TsBeNz/Narwhal-Robot-Embedded-Systems/README.md

# Module89-Frab5-G3
Electronics &amp; Embedded Systems
