TsBeNz/Narwhal-Robot-Embedded-Systems/Matlabscript_simscape/Simscape/NarwhaleCAD/GripperASM.STL

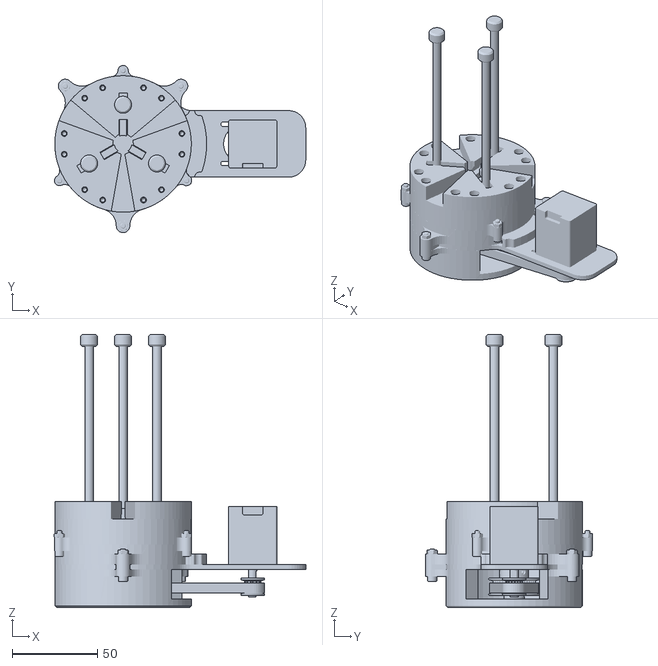
[picture p1: CAD file, 2022-02-24]
Matlabscript_simscape/Simscape/NarwhaleCAD/GripperASM.STL
147.4 x 98.0 x 160.0
