TsBeNz/Narwhal-Robot-Embedded-Systems/Matlabscript_simscape/Simscape/NarwhaleCAD/assJ5.SLDASM

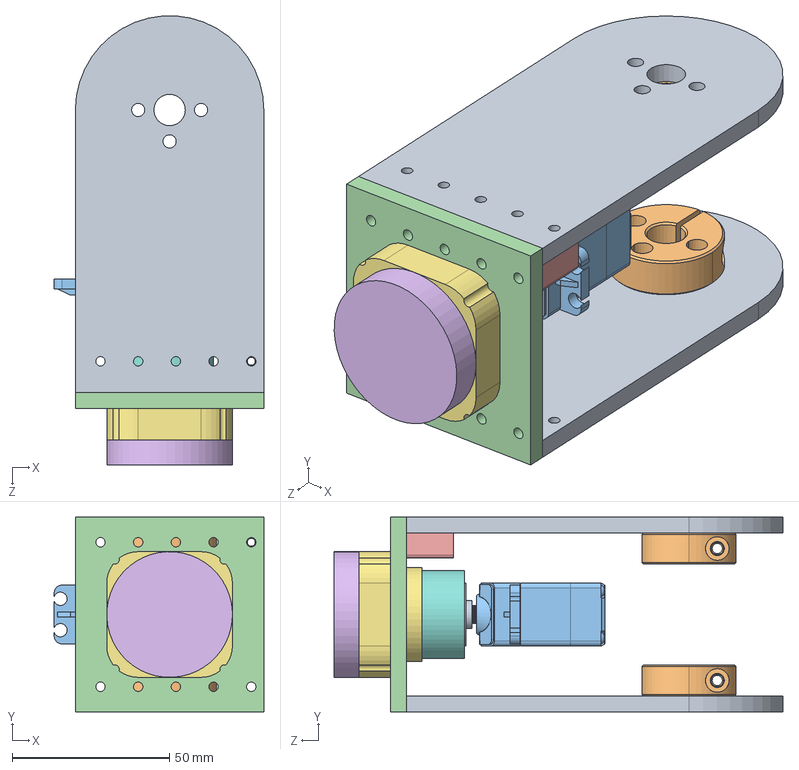
[picture p2: CAD file, 2022-01-18]
Matlabscript_simscape/Simscape/NarwhaleCAD/assJ5.SLDASM
66.8 x 62.0 x 142.9 mm
SP_J5 x 2
PSCST10_10_5 x 2
end-effector-servo
SP5
Lock
mount_gripper
mount_bearing
Servo_connect
servo-rotator-plate
SFLC608ZZ
