TsBeNz/Narwhal-Robot-Embedded-Systems/(list of files, cad)

Other CAD files:
Matlabscript_simscape/Simscape/NarwhaleCAD/J5.STEP
Matlabscript_simscape/Simscape/NarwhaleCAD/link4.STL
