TsBeNz/Narwhal-Robot-Embedded-Systems/Board/NarwhelMainV2/NarwhelMainV2.pdf

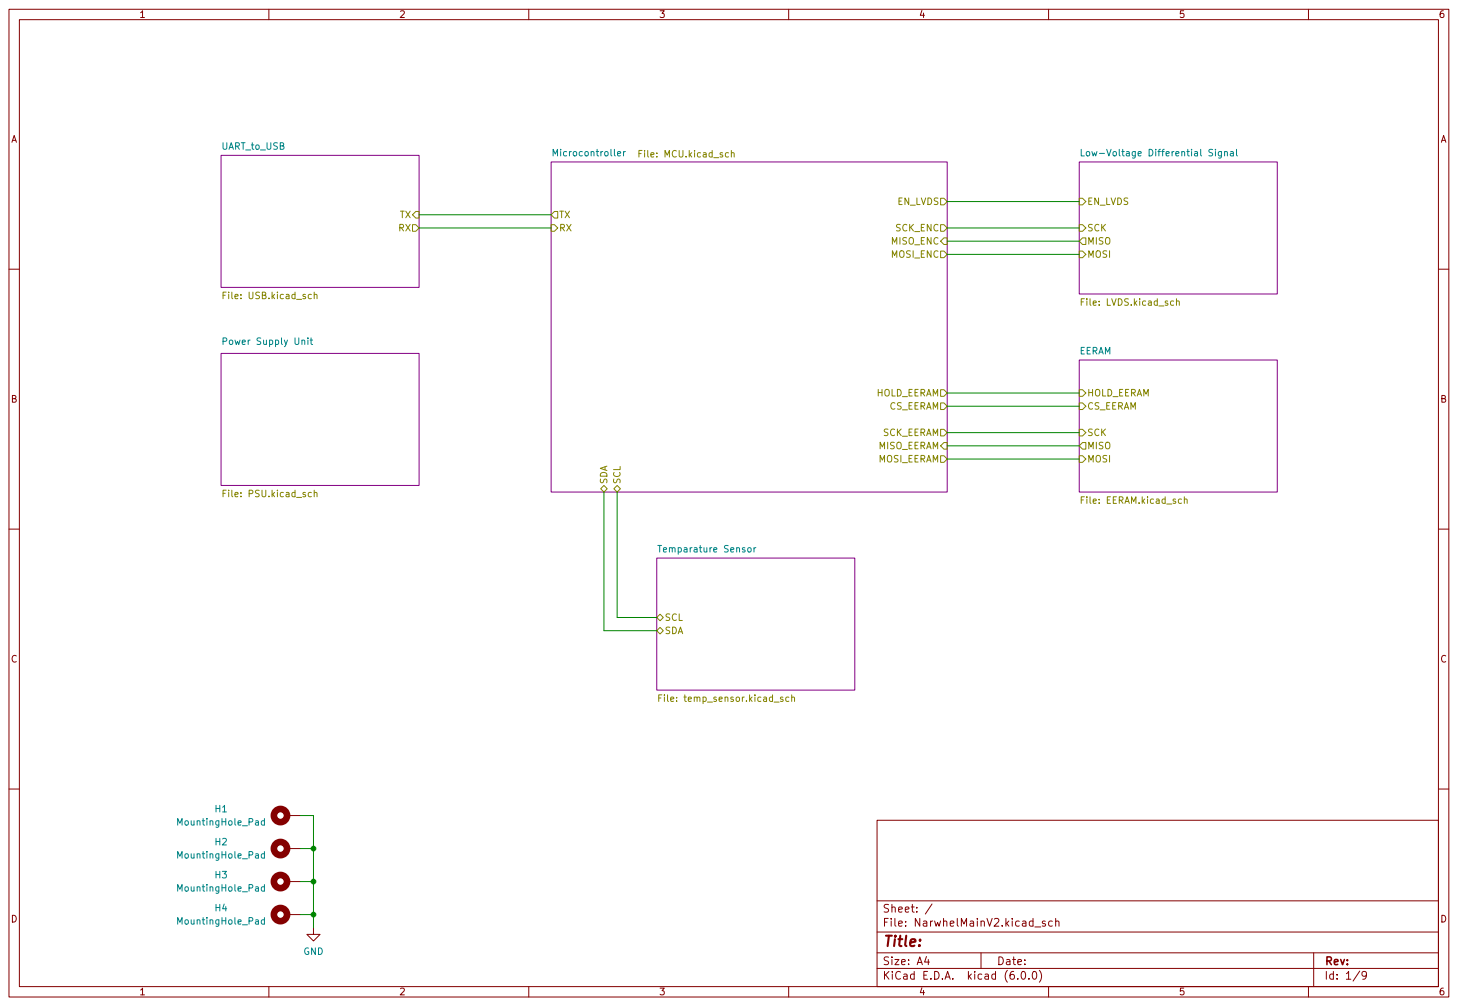
[picture p3: page 1]

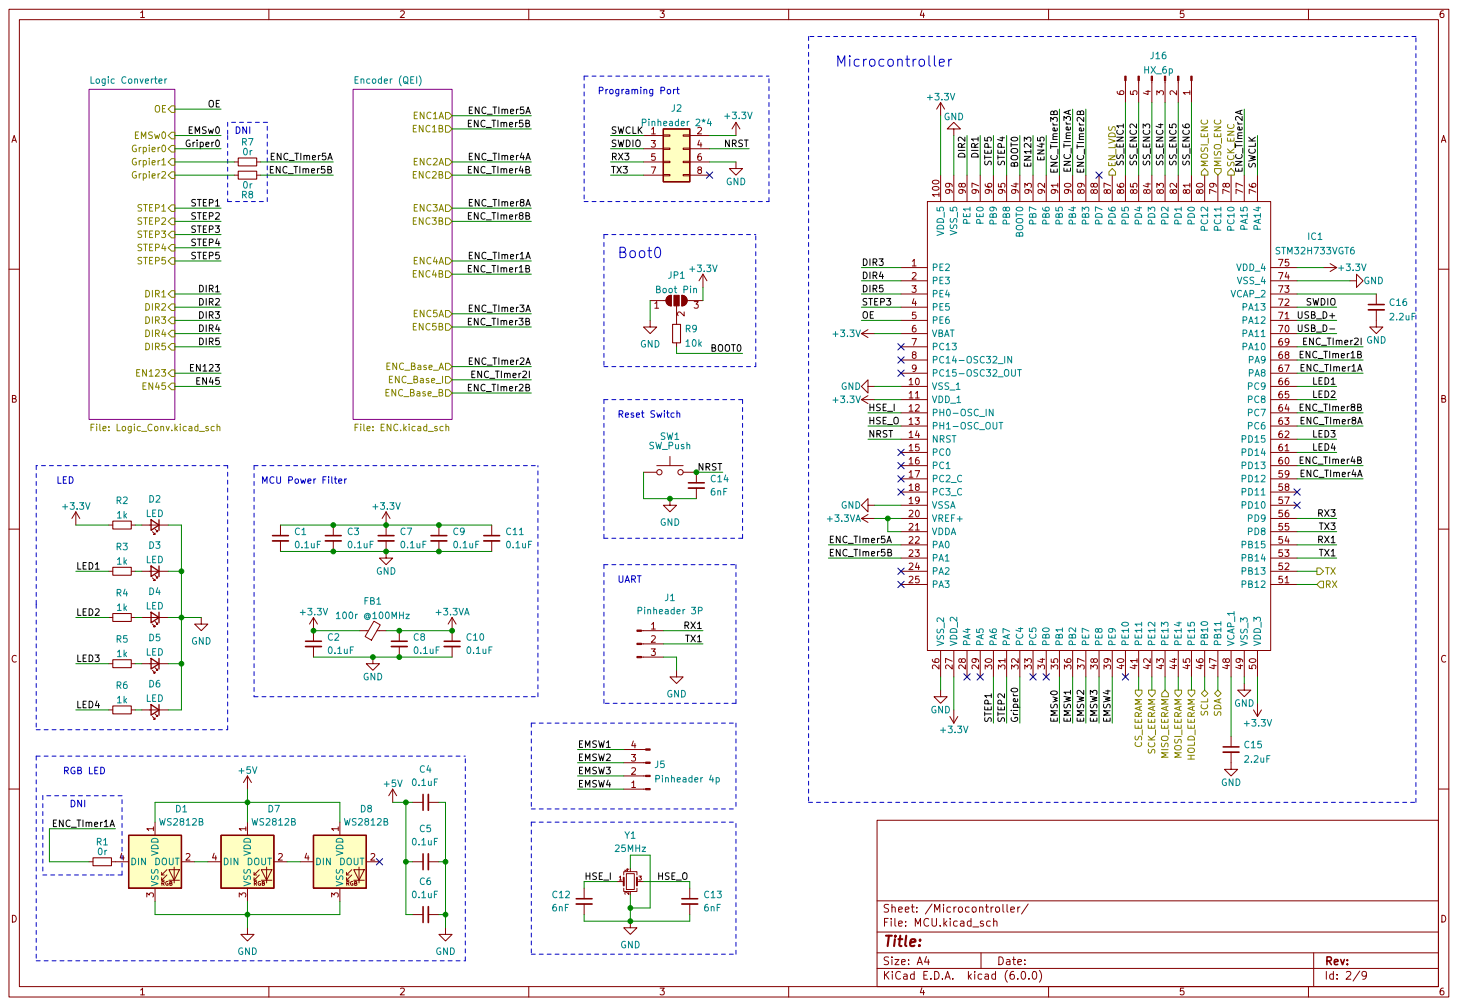
[picture p4: page 2]

File: MCU.kicad_sch Sheet: /Microcontroller/
Id: 2/9 Title:

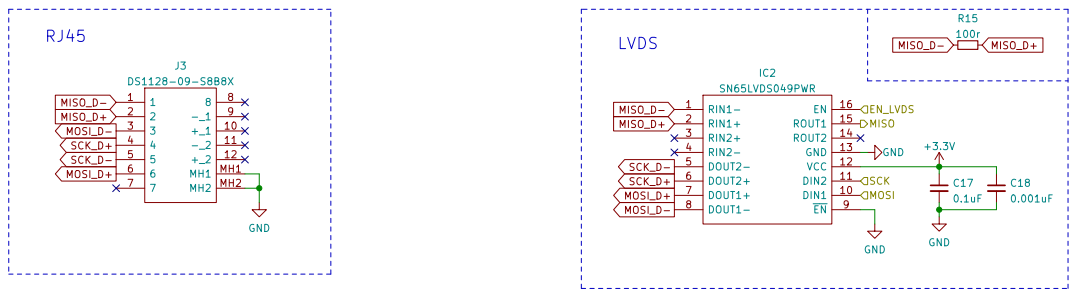
[picture p5: page 3]

Sheet: /Low-Voltage Differential Signal/ GND GND

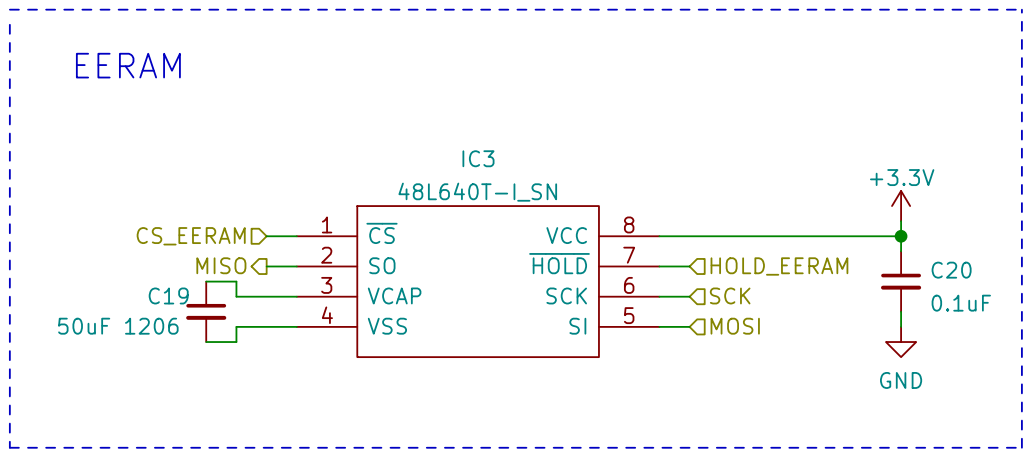
[picture p6: page 4]

File: EERAM.kicad_sch Sheet: /EERAM/ C19

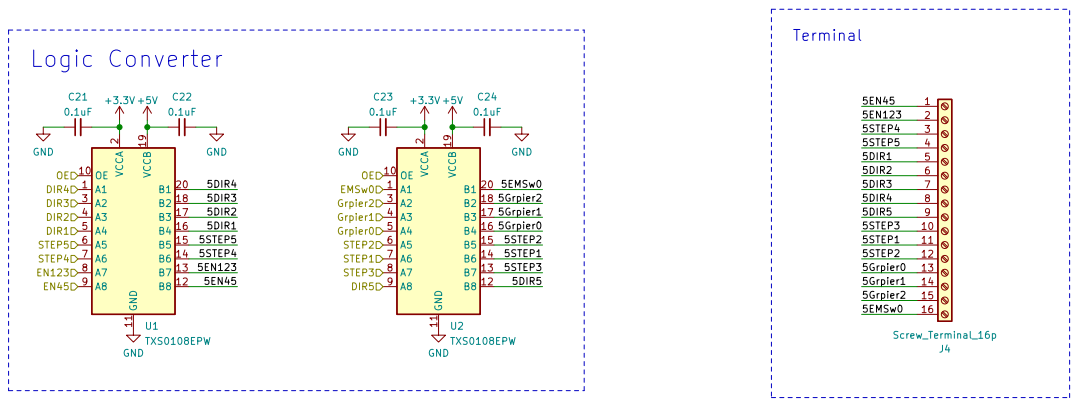
[picture p7: page 5]

Sheet: /Microcontroller/Logic Converter/
File: Logic_Conv.kicad_sch
Id: 5/9 Title:

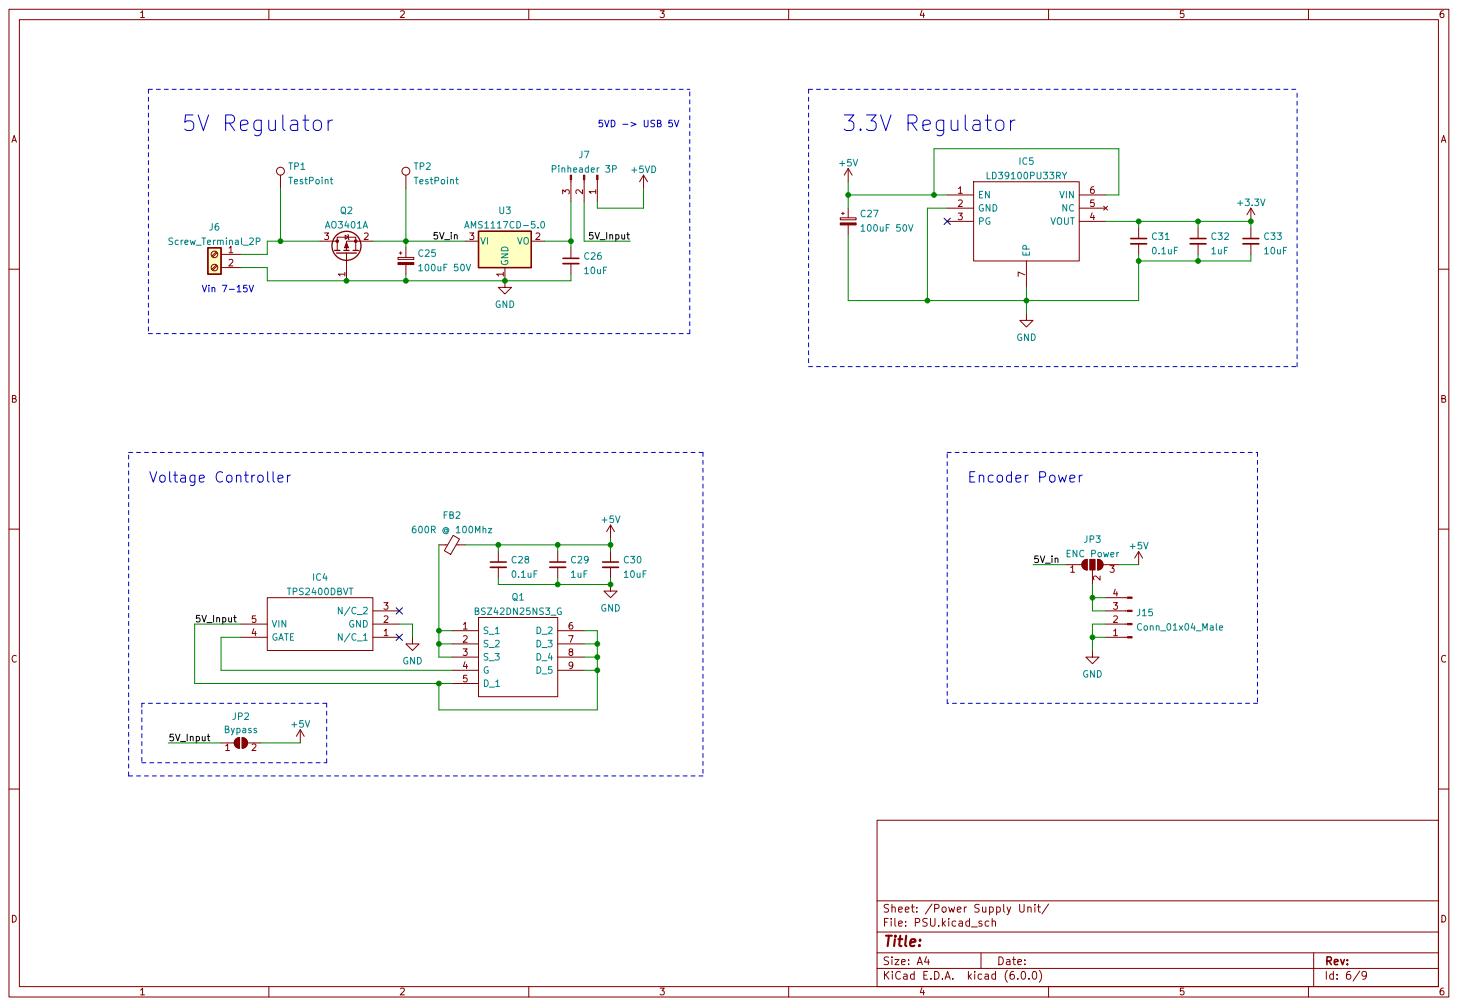
[picture p8: page 6]

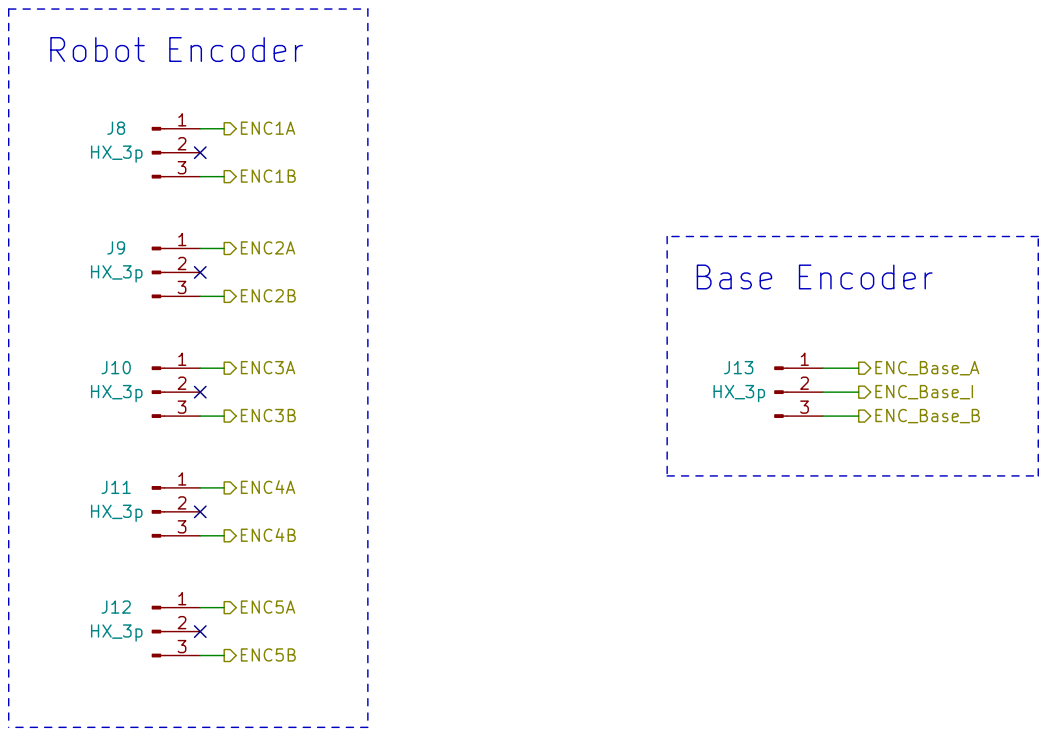
[picture p9: page 7]

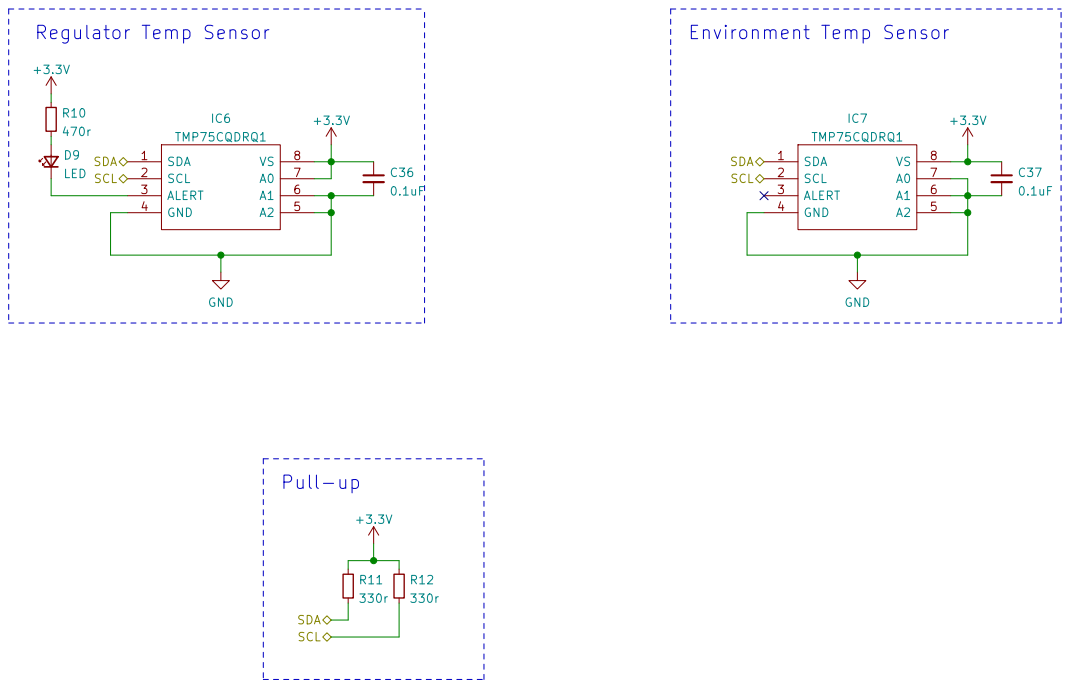
[picture p10: page 8]

Sheet: /Temparature Sensor/ GND

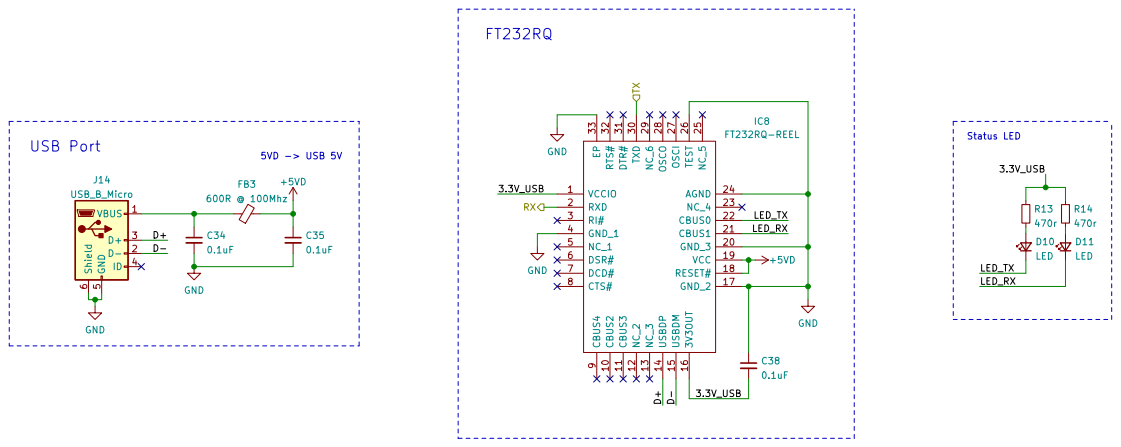
[picture p11: page 9]
