TsBeNz/Narwhal-Robot-Embedded-Systems/Board/NarWhelEncoderV2/NarWhelEncoderV2.kicad_pcb

## KiCad design Board/NarWhelEncoderV2/NarWhelEncoderV2.kicad_pcb (2022-01-24)

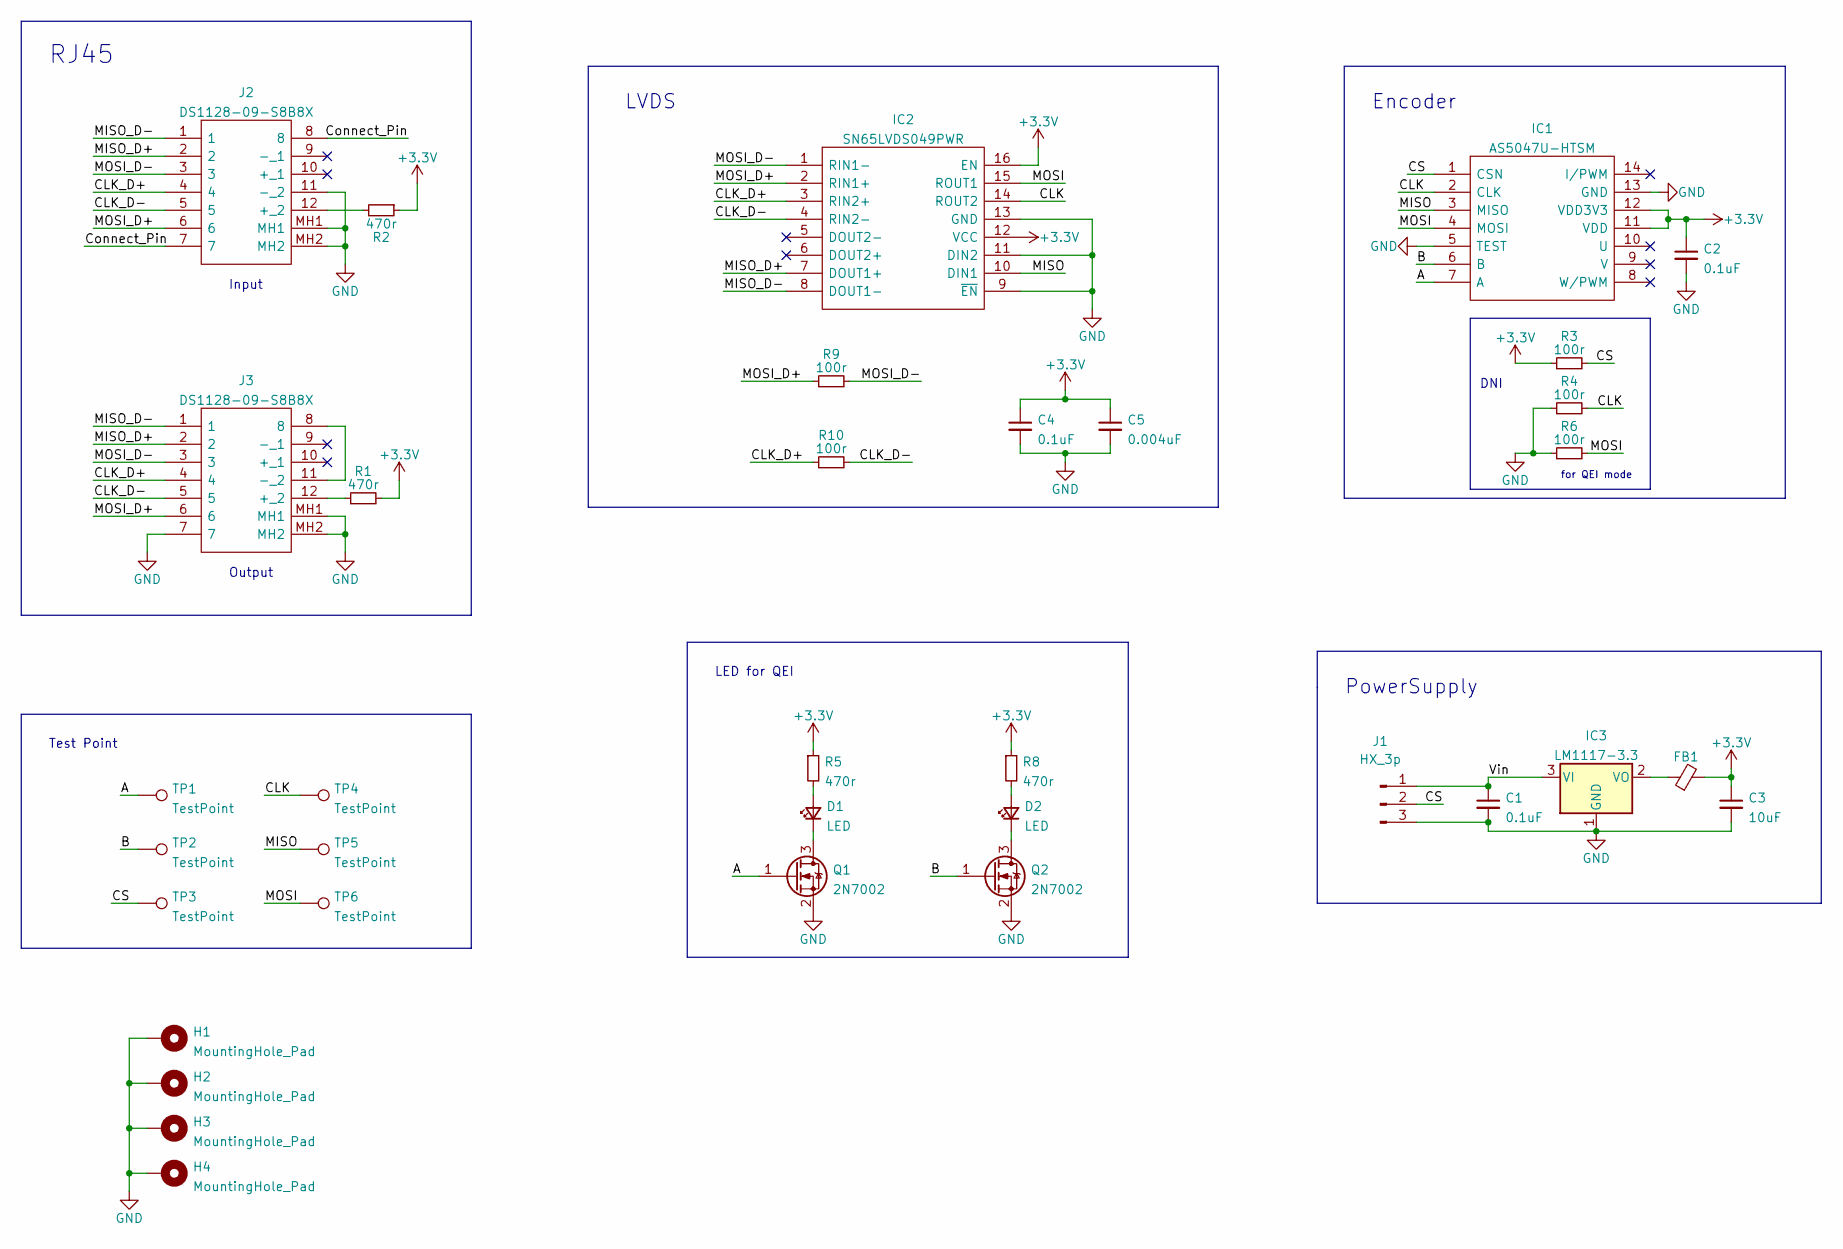
[picture p12: schematic NarWhelEncoderV2.kicad_sch]

Parts:
C1, C2, C4: 0.1uF; C_0603_1608Metric_Pad1.08x0.95mm_HandSolder
C3: 10uF; C_0603_1608Metric_Pad1.08x0.95mm_HandSolder
C5: 0.004uF; C_0603_1608Metric_Pad1.08x0.95mm_HandSolder
D1, D2: LED; LED_0603_1608Metric_Pad1.05x0.95mm_HandSolder
FB1: FerriteBead_Small; L_0603_1608Metric_Pad1.05x0.95mm_HandSolder
H1, H2, H3, H4: MountingHole_Pad; MountingHole_3.2mm_M3_Pad_Via
IC1: AS5047U-HTSM; SOP65P640X120-14N; Manufacturer_Part_Number AS5047U-HTSM; Mouser Part Number 985-AS5047U-HTSM
IC2: SN65LVDS049PWR; SOP65P640X120-16N; Manufacturer_Part_Number SN65LVDS049PWR; Mouser Part Number 595-SN65LVDS049PWR
IC3: LM1117-3.3; SOT-223-3_TabPin2
J1: HX_3p; JST_XH_B3B-XH-A_1x03_P2.50mm_Vertical
J2, J3: DS1128-09-S8B8X; DS112809S8B8X; Manufacturer_Part_Number DS1128-09-S8B8X
Q1, Q2: 2N7002; SOT-23_Handsoldering
R1, R2, R5, R8: 470r; R_0603_1608Metric_Pad0.98x0.95mm_HandSolder
R3, R4, R6, R9, R10: 100r; R_0603_1608Metric_Pad0.98x0.95mm_HandSolder
TP1, TP2, TP3, TP4, TP5, TP6: TestPoint; TestPoint_Pad_D1.5mm

Connections:
+3V3: C2.1, C3.1, C4.1, C5.1, FB1.2, IC1.11 (VDD), IC1.12 (VDD3V3), IC2.12 (VCC), IC2.16 (EN), R1.2, R2.1, R3.1, R5.1, R8.1
/A: IC1.7 (A), Q1.1 (G), TP1.1
/B: IC1.6 (B), Q2.1 (G), TP2.1
/CLK: IC1.2 (CLK), IC2.14 (ROUT2), R4.2, TP4.1
/CLK_D+: IC2.3 (RIN2+), J2.4, J3.4, R10.1
/CLK_D-: IC2.4 (RIN2-), J2.5, J3.5, R10.2
/CS: IC1.1 (CSN), J1.2, R3.2, TP3.1
/Connect_Pin: J2.7, J2.8
/MISO: IC1.3 (MISO), IC2.10 (DIN1), TP5.1
/MISO_D+: IC2.7 (DOUT1+), J2.2, J3.2
/MISO_D-: IC2.8 (DOUT1-), J2.1, J3.1
/MOSI: IC1.4 (MOSI), IC2.15 (ROUT1), R6.2, TP6.1
/MOSI_D+: IC2.2 (RIN1+), J2.6, J3.6, R9.1
/MOSI_D-: IC2.1 (RIN1-), J2.3, J3.3, R9.2
/Vin: C1.1, IC3.3 (VI), J1.1
GND: C1.2, C2.2, C3.2, C4.2, C5.2, H1.1, H2.1, H3.1, H4.1, IC1.5 (TEST), IC1.13 (GND), IC2.9 (~EN), IC2.11 (DIN2), IC2.13 (GND), IC3.1 (GND), J1.3, J2.11 (-_2), J2.MH1, J2.MH2, J3.7, J3.MH1, J3.MH2, Q1.2 (S), Q2.2 (S), R4.1, R6.1
unnamed: D1.1 (K), Q1.3 (D)
unnamed: D1.2 (A), R5.2
unnamed: D2.1 (K), Q2.3 (D)
unnamed: D2.2 (A), R8.2
unnamed: FB1.1, IC3.2 (VO)
unnamed: J2.12 (+_2), R2.2
unnamed: J3.8, J3.11 (-_2)
unnamed: J3.12 (+_2), R1.1

Notes on the sheet:
LED for QEI
Output
Test Point
Encoder
RJ45
Input
LVDS
PowerSupply
DNI
for QEI mode

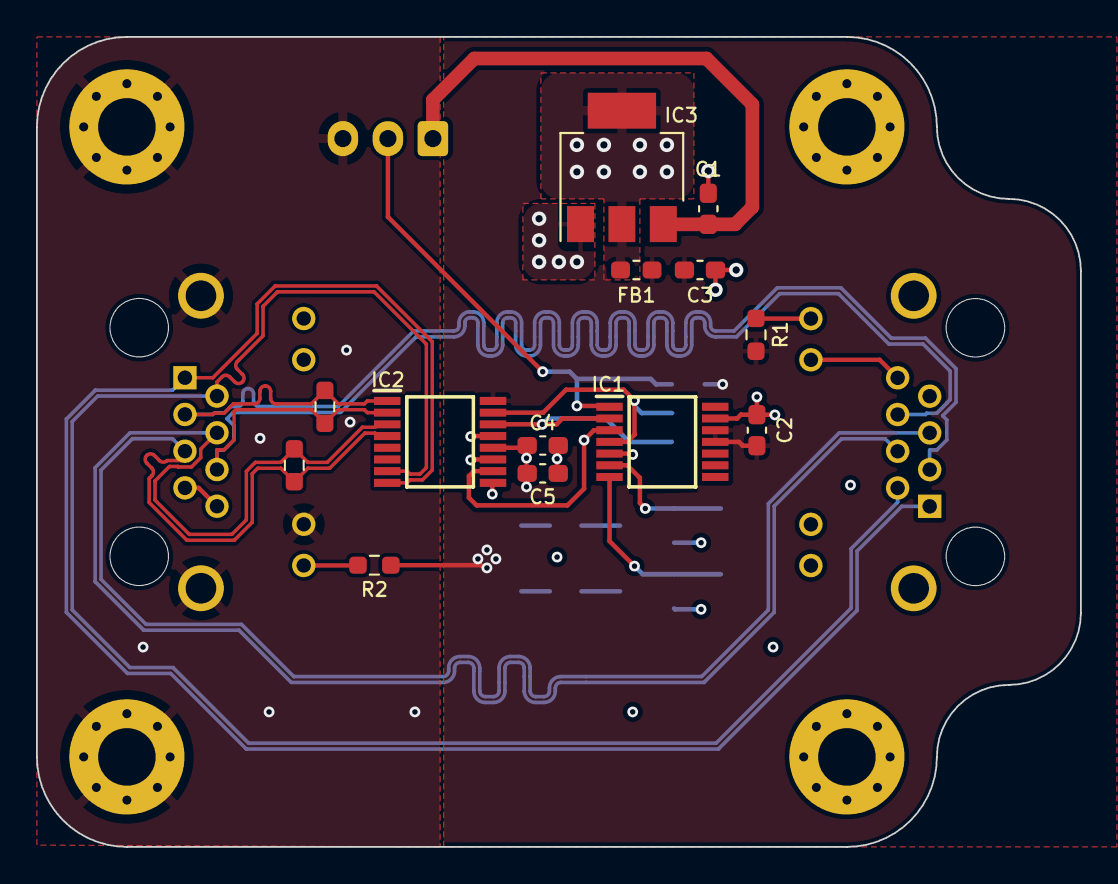
[picture p13: board NarWhelEncoderV2.kicad_pcb from above]

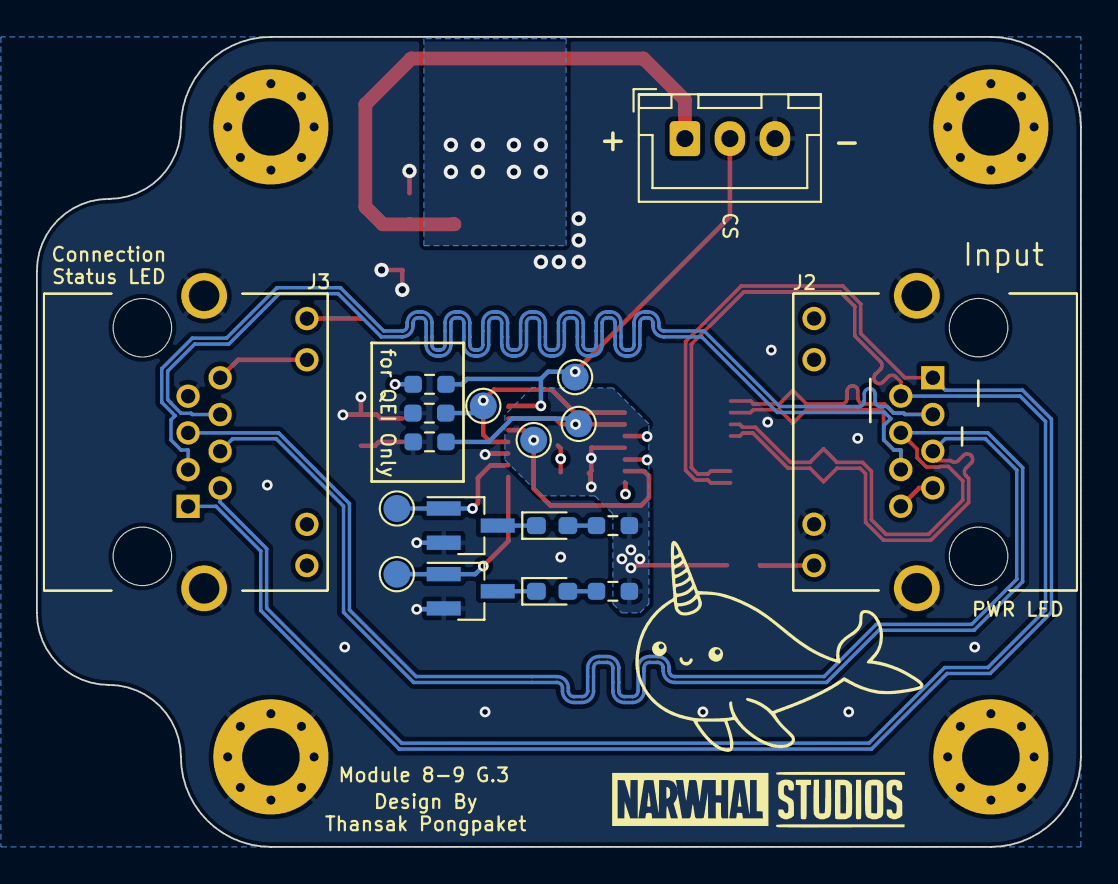
[picture p14: board NarWhelEncoderV2.kicad_pcb from below]

Board: 4 copper layers, 58.0 x 45.0 mm, 35 parts (18 on the bottom side), 24 nets.
