TsBeNz/Narwhal-Robot-Embedded-Systems/Board/NarwhelMainV2/NarwhelMainV2.kicad_pcb

## KiCad design Board/NarwhelMainV2/NarwhelMainV2.kicad_pcb (2022-01-24)

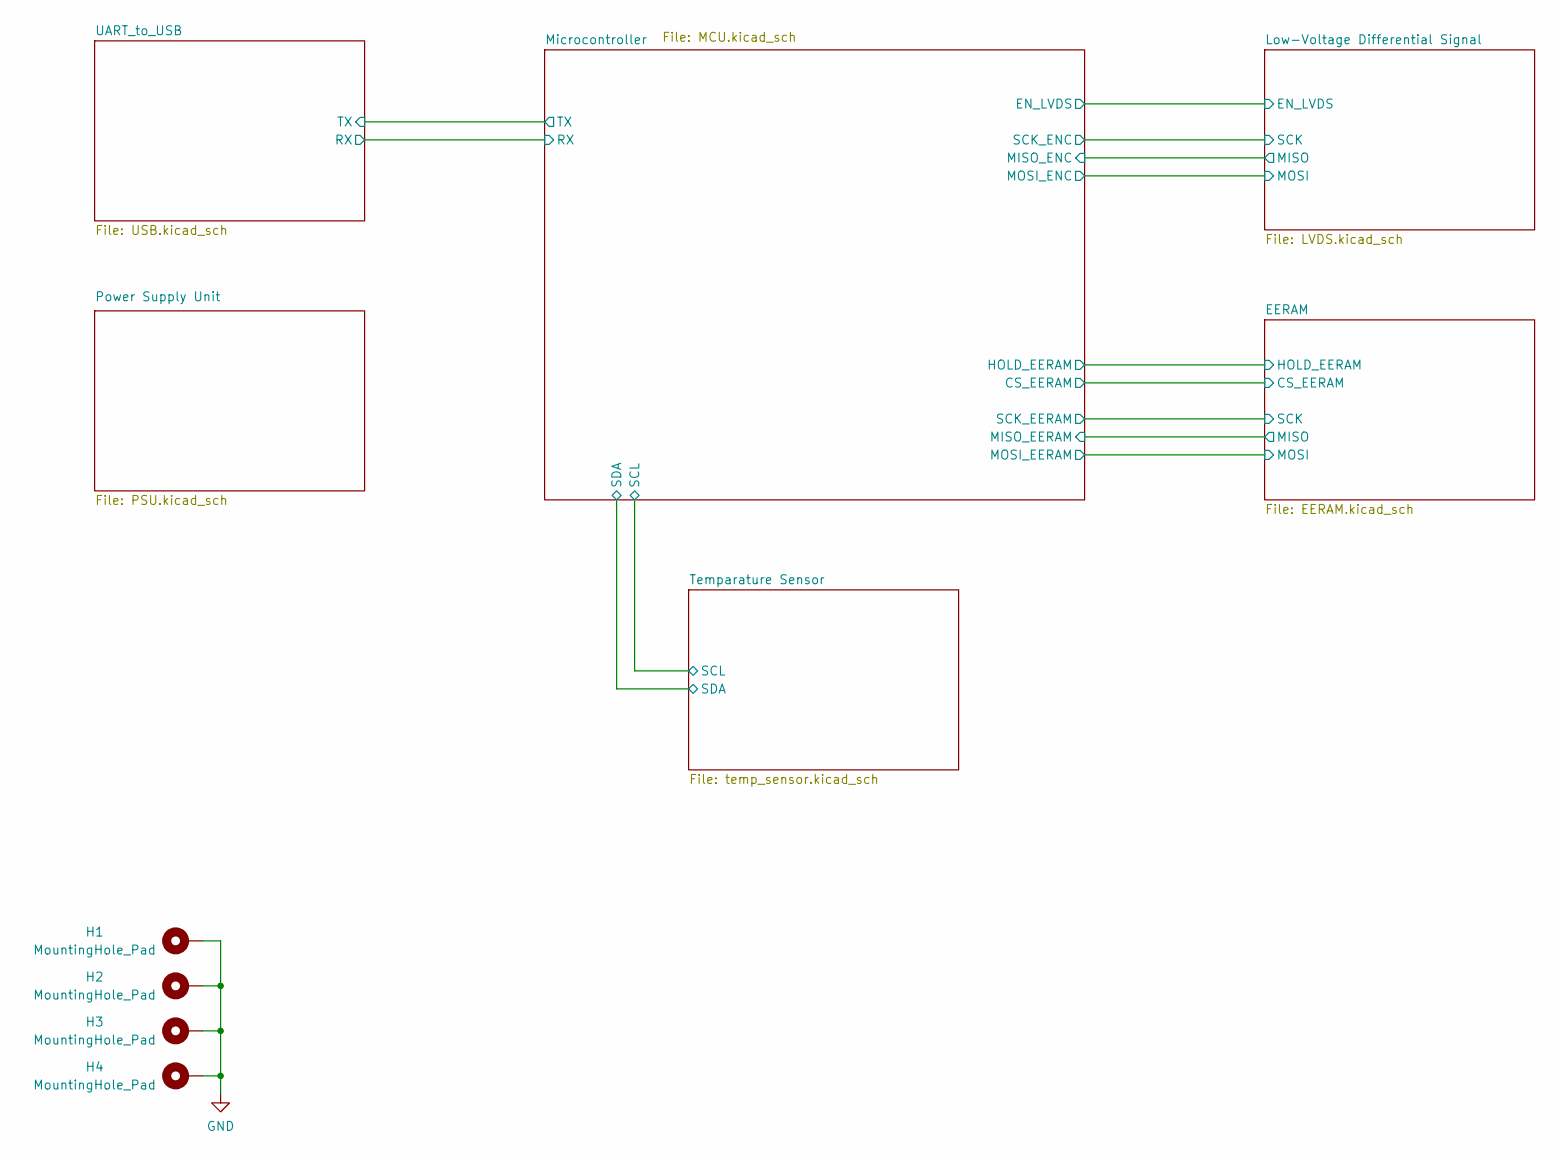
[picture p15: schematic NarwhelMainV2.kicad_sch]

Parts:
H1, H2, H3, H4: MountingHole_Pad; MountingHole_3.2mm_M3_Pad_Via

Connections:
GND: H1.1, H2.1, H3.1, H4.1; also elsewhere on the board

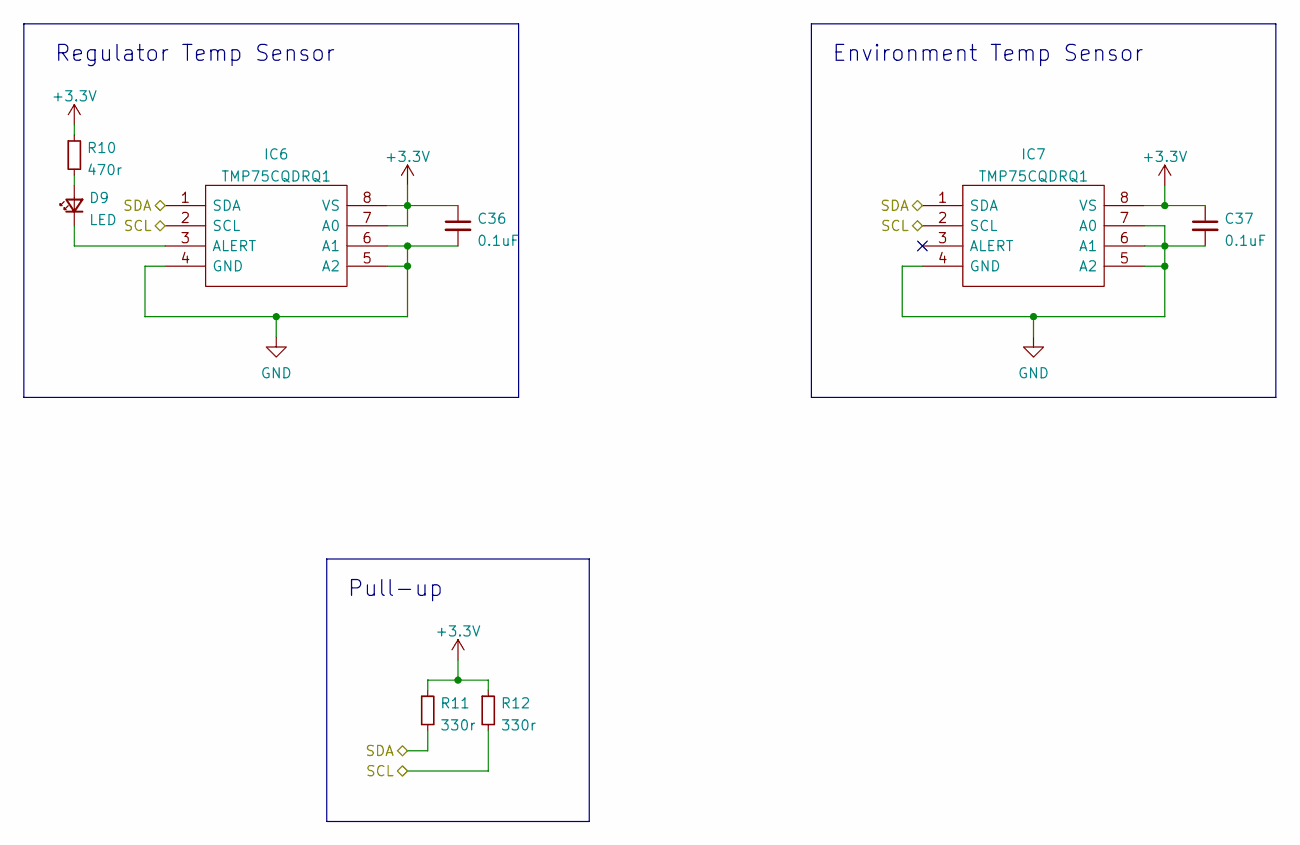
[picture p16: schematic temp_sensor.kicad_sch]

Parts:
C36, C37: 0.1uF; C_0603_1608Metric_Pad1.08x0.95mm_HandSolder
D9: LED; LED_0603_1608Metric_Pad1.05x0.95mm_HandSolder
IC6, IC7: TMP75CQDRQ1; SOIC127P600X175-8N; Manufacturer_Part_Number TMP75CQDRQ1; Mouser Part Number 595-TMP75CQDRQ1
R10: 470r; R_0603_1608Metric_Pad0.98x0.95mm_HandSolder
R11, R12: 330r; R_0603_1608Metric_Pad0.98x0.95mm_HandSolder

Connections:
+3V3: C36.1, C37.1, IC6.7 (A0), IC6.8 (VS), IC7.8 (VS), R10.1, R11.1, R12.1; also elsewhere on the board
/Microcontroller/SCL: IC6.2 (SCL), IC7.2 (SCL), R12.2; also elsewhere on the board
/Microcontroller/SDA: IC6.1 (SDA), IC7.1 (SDA), R11.2; also elsewhere on the board
GND: C36.2, C37.2, IC6.4 (GND), IC6.5 (A2), IC6.6 (A1), IC7.4 (GND), IC7.5 (A2), IC7.6 (A1), IC7.7 (A0); also elsewhere on the board
unnamed: D9.1 (K), IC6.3 (ALERT)
unnamed: D9.2 (A), R10.2

Notes on the sheet:
Regulator Temp Sensor
Environment Temp Sensor
Pull-up

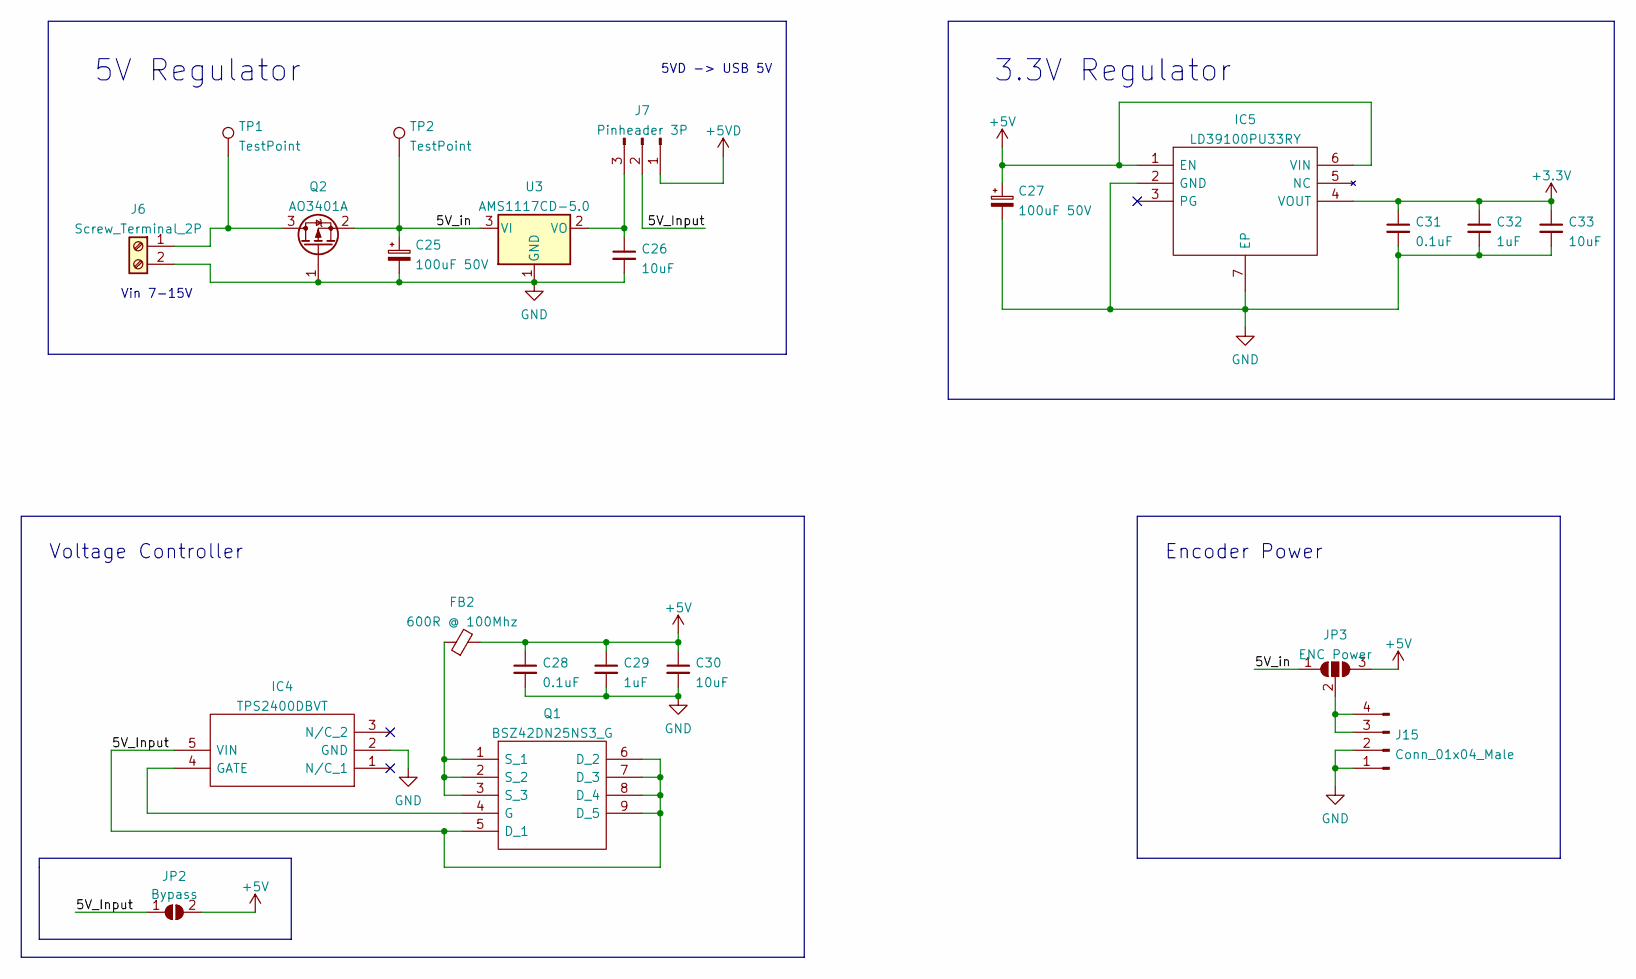
[picture p17: schematic PSU.kicad_sch]

Parts:
C25, C27: 100uF 50V; CP_Elec_6.3x5.4_Nichicon
C26, C30, C33: 10uF; C_0603_1608Metric_Pad1.08x0.95mm_HandSolder
C28, C31: 0.1uF; C_0603_1608Metric_Pad1.08x0.95mm_HandSolder
C29, C32: 1uF; C_0603_1608Metric_Pad1.08x0.95mm_HandSolder
FB2: 600R @ 100Mhz; L_0603_1608Metric_Pad1.05x0.95mm_HandSolder
IC4: TPS2400DBVT; SOT95P280X145-5N; Manufacturer_Part_Number TPS2400DBVT; Mouser Part Number 595-TPS2400DBVT
IC5: LD39100PU33RY; SON95P300X300X90-7N-D; Manufacturer_Part_Number LD39100PU33RY; Mouser Part Number 511-LD39100PU33RY
J6: Screw_Terminal_2P; TerminalBlock_Phoenix_MKDS-1,5-2_1x02_P5.00mm_Horizontal
J7: Pinheader 3P; PinHeader_1x03_P2.54mm_Vertical
J15: Conn_01x04_Male; JST_XH_B4B-XH-A_1x04_P2.50mm_Vertical
JP2: Bypass; SolderJumper-2_P1.3mm_Open_RoundedPad1.0x1.5mm
JP3: ENC Power; SolderJumper-3_P1.3mm_Open_RoundedPad1.0x1.5mm
Q1: BSZ42DN25NS3_G; BSZ42DN25NS3G; Manufacturer_Part_Number BSZ42DN25NS3 G; Mouser Part Number 726-BSZ42DN25NS3G
Q2: AO3401A; SOT-23
TP1, TP2: TestPoint; TestPoint_THTPad_D2.0mm_Drill1.0mm
U3: AMS1117CD-5.0; TO-252-3_TabPin2

Connections:
+3V3: C31.1, C32.1, C33.1, IC5.4 (VOUT); also elsewhere on the board
+5V: C27.1, C28.1, C29.1, C30.1, FB2.2, IC5.1 (EN), IC5.6 (VIN), JP2.2 (B), JP3.3 (B); also elsewhere on the board
+5VD: J7.1; also elsewhere on the board
/Power Supply Unit/5V_Input: IC4.5 (VIN), J7.2, JP2.1 (A), Q1.5 (D_1), Q1.6 (D_2), Q1.7 (D_3), Q1.8 (D_4), Q1.9 (D_5)
/Power Supply Unit/5V_in: C25.1, JP3.1 (A), Q2.2 (S), TP2.1, U3.3 (VI)
GND: C25.2, C26.2, C27.2, C28.2, C29.2, C30.2, C31.2, C32.2, C33.2, IC4.2 (GND), IC5.2 (GND), IC5.7 (EP), J6.2, J15.1, J15.2, Q2.1 (G), U3.1 (GND); also elsewhere on the board
unnamed: C26.1, J7.3, U3.2 (VO)
unnamed: FB2.1, Q1.1 (S_1), Q1.2 (S_2), Q1.3 (S_3)
unnamed: IC4.4 (GATE), Q1.4 (G)
unnamed: J6.1, Q2.3 (D), TP1.1
unnamed: J15.3, J15.4, JP3.2 (C)

Notes on the sheet:
5V Regulator
5VD -> USB 5V
Encoder Power
Voltage Controller
3.3V Regulator
Vin 7-15V

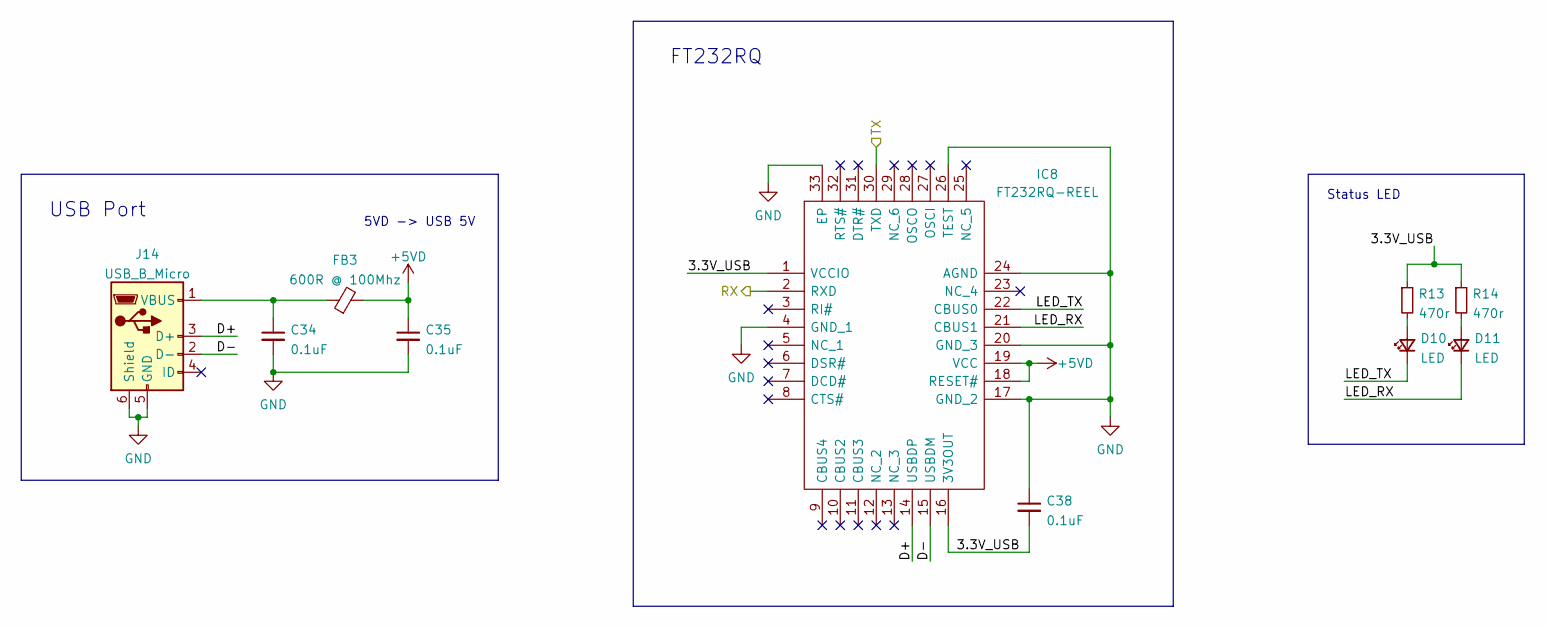
[picture p18: schematic USB.kicad_sch]

Parts:
C34, C35, C38: 0.1uF; C_0603_1608Metric_Pad1.08x0.95mm_HandSolder
D10, D11: LED; LED_0603_1608Metric_Pad1.05x0.95mm_HandSolder
FB3: 600R @ 100Mhz; L_0603_1608Metric_Pad1.05x0.95mm_HandSolder
IC8: FT232RQ-REEL; QFN50P500X500X90-33N-D; Manufacturer_Part_Number FT232RQ-REEL; Mouser Part Number 895-FT232RQ
J14: USB_B_Micro; USB_Micro-B_Molex_47346-0001
R13, R14: 470r; R_0603_1608Metric_Pad0.98x0.95mm_HandSolder

Connections:
+5VD: C35.1, FB3.2, IC8.18 (RESET#), IC8.19 (VCC); also elsewhere on the board
/Microcontroller/RX: IC8.2 (RXD); also elsewhere on the board
/Microcontroller/TX: IC8.30 (TXD); also elsewhere on the board
/UART_to_USB/3.3V_USB: C38.2, IC8.1 (VCCIO), IC8.16 (3V3OUT), R13.1, R14.1
/UART_to_USB/D+: IC8.14 (USBDP), J14.3 (D+)
/UART_to_USB/D-: IC8.15 (USBDM), J14.2 (D-)
/UART_to_USB/LED_RX: D11.1 (K), IC8.21 (CBUS1)
/UART_to_USB/LED_TX: D10.1 (K), IC8.22 (CBUS0)
GND: C34.2, C35.2, C38.1, IC8.4 (GND_1), IC8.17 (GND_2), IC8.20 (GND_3), IC8.24 (AGND), IC8.26 (TEST), IC8.33 (EP), J14.5 (GND), J14.6 (Shield); also elsewhere on the board
unnamed: C34.1, FB3.1, J14.1 (VBUS)
unnamed: D10.2 (A), R13.2
unnamed: D11.2 (A), R14.2

Notes on the sheet:
FT232RQ
5VD -> USB 5V
Status LED
USB Port

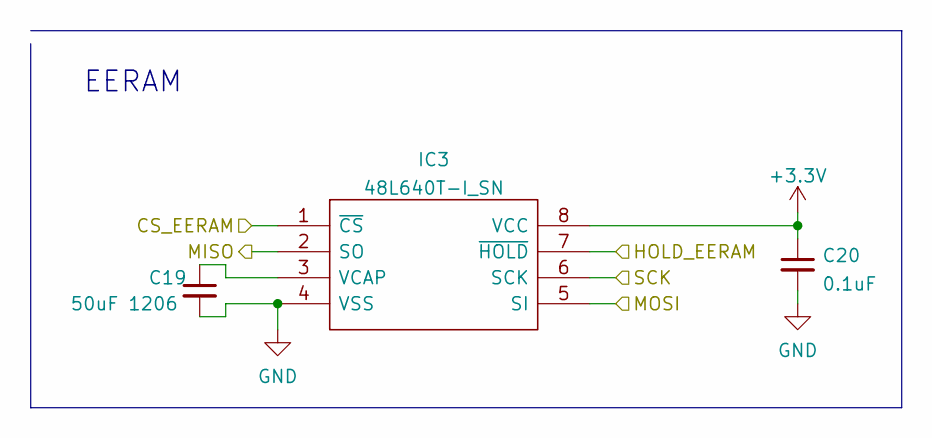
[picture p19: schematic EERAM.kicad_sch]

Parts:
C19: 50uF 1206; C_1206_3216Metric_Pad1.33x1.80mm_HandSolder
C20: 0.1uF; C_0603_1608Metric_Pad1.08x0.95mm_HandSolder
IC3: 48L640T-I_SN; SOIC127P600X175-8N; Manufacturer_Part_Number 48L640T-I/SN; Mouser Part Number 579-48L640T-I/SN

Connections:
+3V3: C20.1, IC3.8 (VCC); also elsewhere on the board
/EERAM/CS_EERAM: IC3.1 (~CS); also elsewhere on the board
/EERAM/HOLD_EERAM: IC3.7 (~HOLD); also elsewhere on the board
/EERAM/MISO: IC3.2 (SO); also elsewhere on the board
/EERAM/MOSI: IC3.5 (SI); also elsewhere on the board
/EERAM/SCK: IC3.6 (SCK); also elsewhere on the board
GND: C19.2, C20.2, IC3.4 (VSS); also elsewhere on the board
unnamed: C19.1, IC3.3 (VCAP)

Notes on the sheet:
EERAM

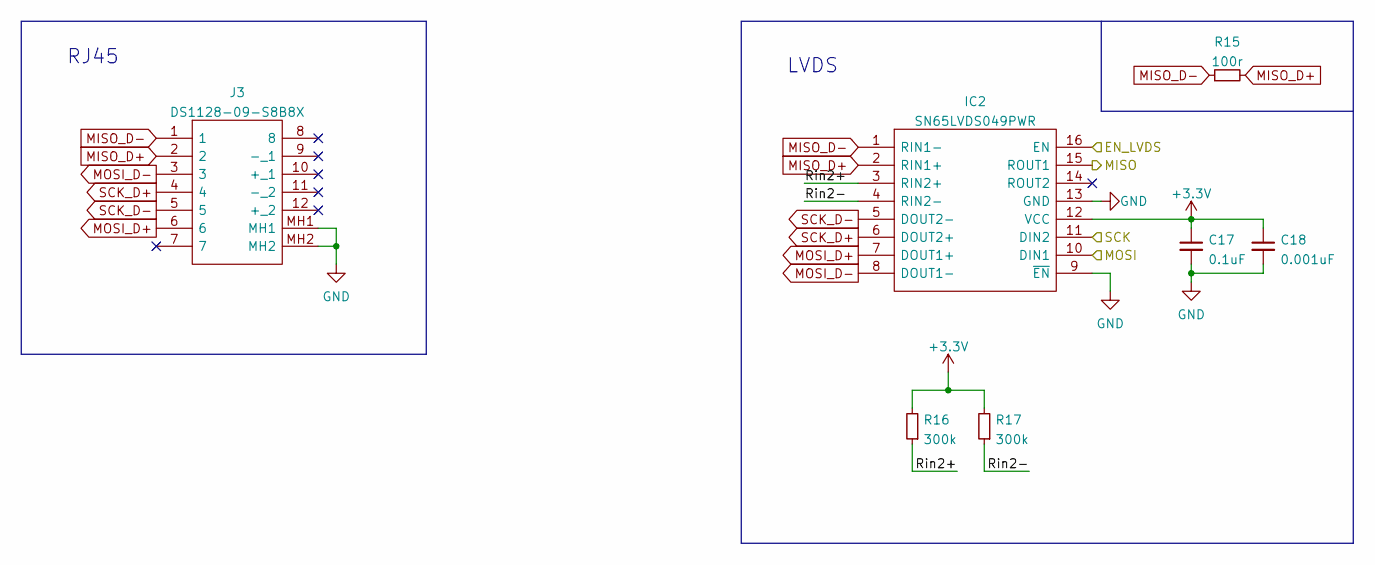
[picture p20: schematic LVDS.kicad_sch]

Parts:
C17: 0.1uF; C_0603_1608Metric_Pad1.08x0.95mm_HandSolder
C18: 0.001uF; C_0603_1608Metric_Pad1.08x0.95mm_HandSolder
IC2: SN65LVDS049PWR; SOP65P640X120-16N; Manufacturer_Part_Number SN65LVDS049PWR; Mouser Part Number 595-SN65LVDS049PWR
J3: DS1128-09-S8B8X; DS112809S8B8X; Manufacturer_Part_Number DS1128-09-S8B8X
R15: 100r; R_0603_1608Metric_Pad0.98x0.95mm_HandSolder
R16, R17: 300k; R_0402_1005Metric_Pad0.72x0.64mm_HandSolder

Connections:
+3V3: C17.1, C18.1, IC2.12 (VCC), R16.2, R17.2; also elsewhere on the board
/Low-Voltage Differential Signal/EN_LVDS: IC2.16 (EN); also elsewhere on the board
/Low-Voltage Differential Signal/MISO: IC2.15 (ROUT1); also elsewhere on the board
/Low-Voltage Differential Signal/MOSI: IC2.10 (DIN1); also elsewhere on the board
/Low-Voltage Differential Signal/Rin2+: IC2.3 (RIN2+), R16.1
/Low-Voltage Differential Signal/Rin2-: IC2.4 (RIN2-), R17.1
/Low-Voltage Differential Signal/SCK: IC2.11 (DIN2); also elsewhere on the board
GND: C17.2, C18.2, IC2.9 (~EN), IC2.13 (GND), J3.MH1, J3.MH2; also elsewhere on the board
MISO_D+: IC2.2 (RIN1+), J3.2, R15.2
MISO_D-: IC2.1 (RIN1-), J3.1, R15.1
MOSI_D+: IC2.7 (DOUT1+), J3.6
MOSI_D-: IC2.8 (DOUT1-), J3.3
SCK_D+: IC2.6 (DOUT2+), J3.4
SCK_D-: IC2.5 (DOUT2-), J3.5

Notes on the sheet:
RJ45
LVDS

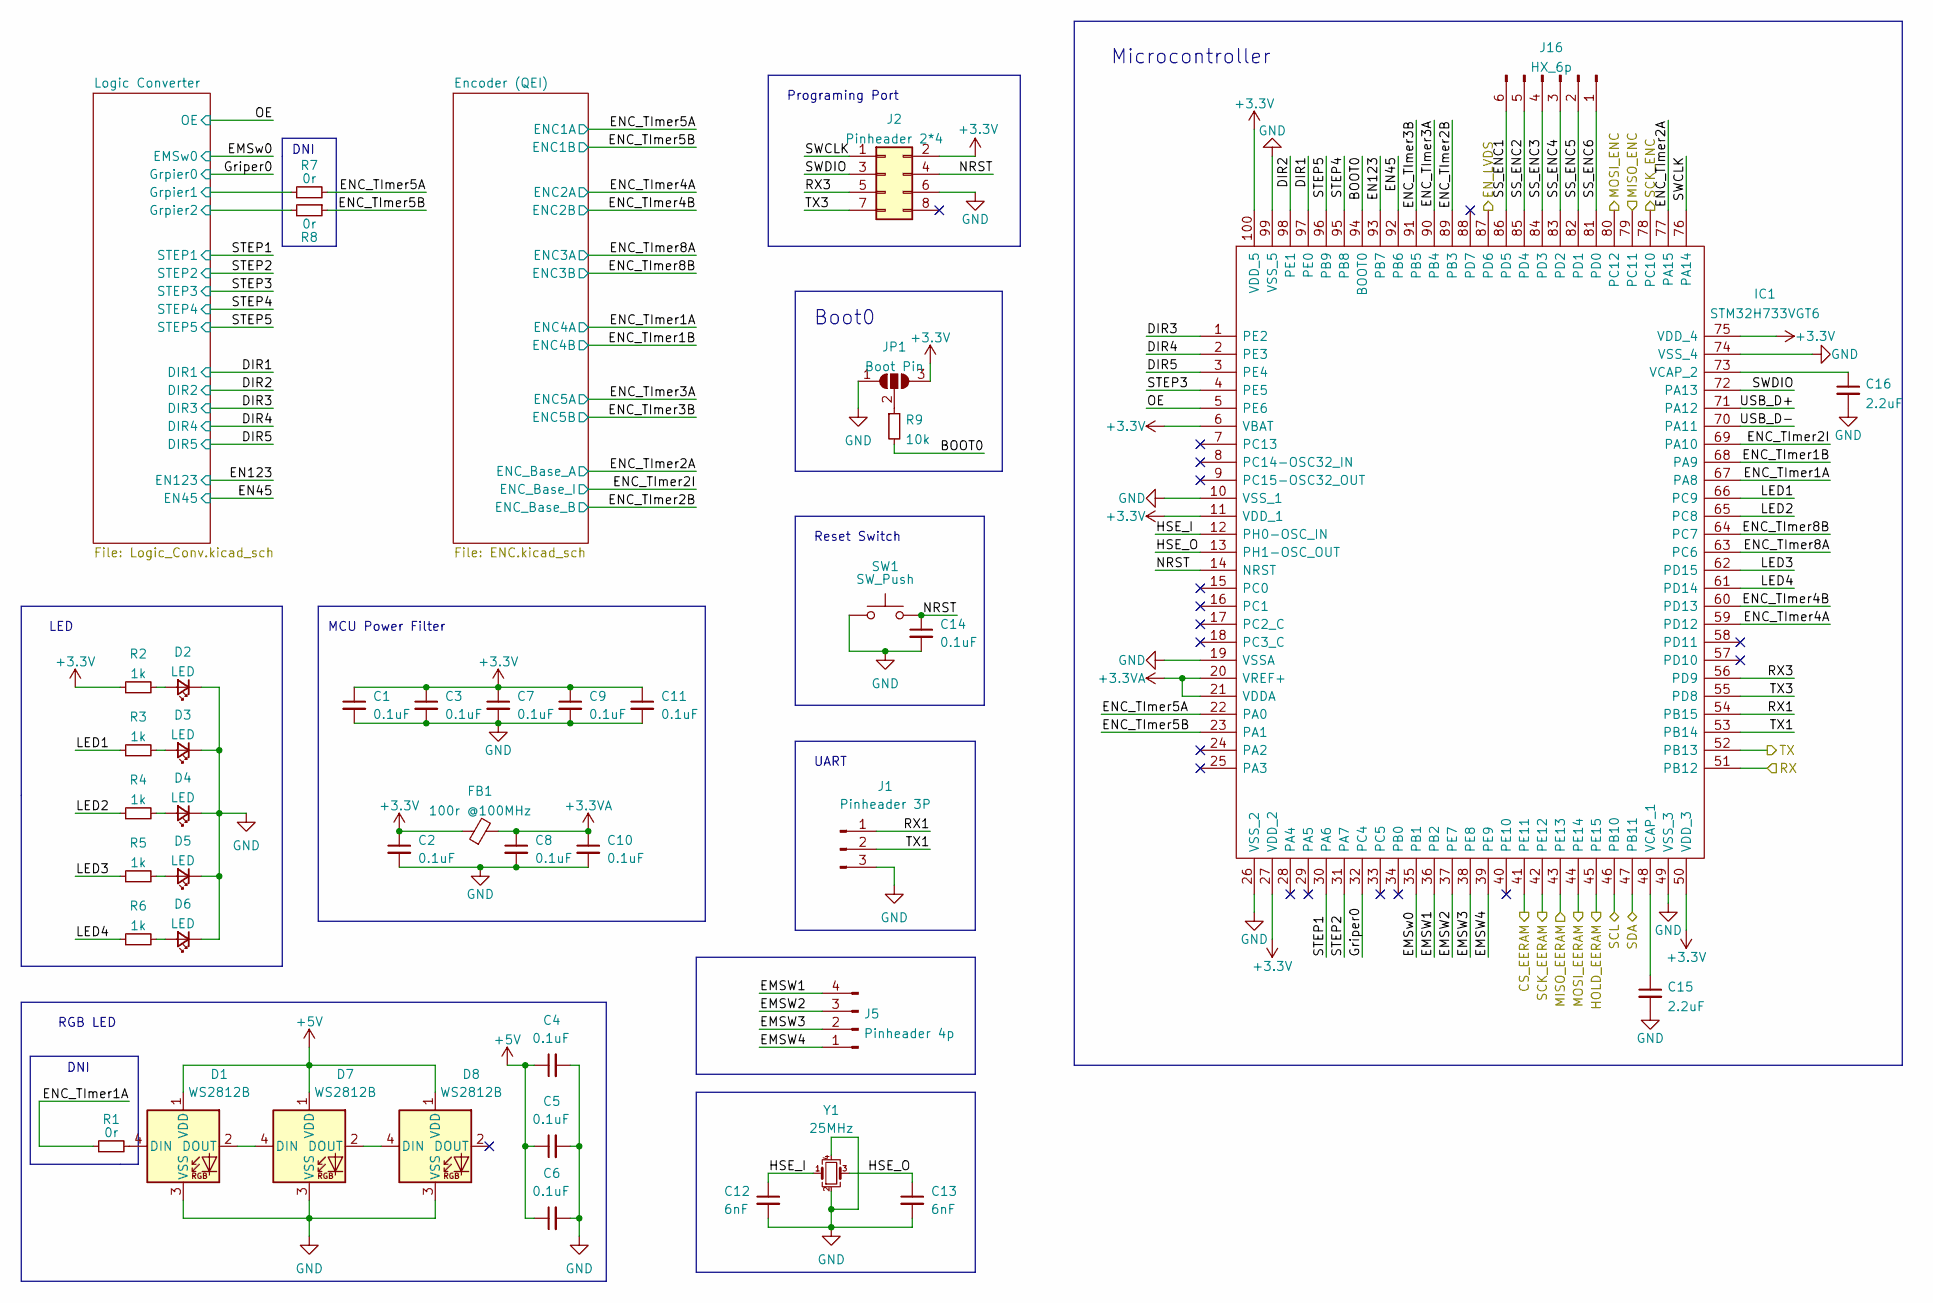
[picture p21: schematic MCU.kicad_sch]

Parts:
C1, C2, C3, C4, C5, C6, C7, C8, C9, C10, C11, C14: 0.1uF; C_0603_1608Metric_Pad1.08x0.95mm_HandSolder
C12, C13: 6nF; C_0603_1608Metric_Pad1.08x0.95mm_HandSolder
C15, C16: 2.2uF; C_0603_1608Metric_Pad1.08x0.95mm_HandSolder
D1, D7, D8: WS2812B; LED_WS2812B_PLCC4_5.0x5.0mm_P3.2mm
D2, D3, D4, D5, D6: LED; LED_0603_1608Metric_Pad1.05x0.95mm_HandSolder
FB1: 100r @100MHz; L_0603_1608Metric_Pad1.05x0.95mm_HandSolder
IC1: STM32H733VGT6; QFP50P1600X1600X160-100N; Manufacturer_Part_Number STM32H733VGT6; Mouser Part Number 511-STM32H733VGT6
J1: Pinheader 3P; PinHeader_1x03_P2.54mm_Vertical
J2: Pinheader 2*4; PinHeader_2x04_P2.54mm_Vertical
J5: Pinheader 4p; PinHeader_1x04_P2.54mm_Vertical
J16: HX_6p; JST_XH_B6B-XH-A_1x06_P2.50mm_Vertical
JP1: Boot Pin; SolderJumper-3_P2.0mm_Open_TrianglePad1.0x1.5mm
R1, R7, R8: 0r; R_0603_1608Metric_Pad0.98x0.95mm_HandSolder
R2, R3, R4, R5, R6: 1k; R_0603_1608Metric_Pad0.98x0.95mm_HandSolder
R9: 10k; R_0603_1608Metric_Pad0.98x0.95mm_HandSolder
SW1: SW_Push; SW_SPST_CK_RS282G05A3
Y1: 25MHz; Crystal_SMD_SeikoEpson_FA238-4Pin_3.2x2.5mm

Connections:
+3.3VA: C8.1, C10.1, FB1.2, IC1.20 (VREF+), IC1.21 (VDDA)
+3V3: C1.1, C2.1, C3.1, C7.1, C9.1, C11.1, FB1.1, IC1.6 (VBAT), IC1.11 (VDD_1), IC1.27 (VDD_2), IC1.50 (VDD_3), IC1.75 (VDD_4), IC1.100 (VDD_5), J2.2, JP1.3 (B), R2.1; also elsewhere on the board
+5V: C4.1, C5.1, C6.1, D1.1 (VDD), D7.1 (VDD), D8.1 (VDD); also elsewhere on the board
/EERAM/CS_EERAM: IC1.41 (PE11); also elsewhere on the board
/EERAM/HOLD_EERAM: IC1.45 (PE15); also elsewhere on the board
/EERAM/MISO: IC1.43 (PE13); also elsewhere on the board
/EERAM/MOSI: IC1.44 (PE14); also elsewhere on the board
/EERAM/SCK: IC1.42 (PE12); also elsewhere on the board
/Low-Voltage Differential Signal/EN_LVDS: IC1.87 (PD6); also elsewhere on the board
/Low-Voltage Differential Signal/MISO: IC1.79 (PC11); also elsewhere on the board
/Low-Voltage Differential Signal/MOSI: IC1.80 (PC12); also elsewhere on the board
/Low-Voltage Differential Signal/SCK: IC1.78 (PC10); also elsewhere on the board
/Microcontroller/BOOT0: IC1.94 (BOOT0), R9.2
/Microcontroller/DIR1: IC1.97 (PE0); also elsewhere on the board
/Microcontroller/DIR2: IC1.98 (PE1); also elsewhere on the board
/Microcontroller/DIR3: IC1.1 (PE2); also elsewhere on the board
/Microcontroller/DIR4: IC1.2 (PE3); also elsewhere on the board
/Microcontroller/DIR5: IC1.3 (PE4); also elsewhere on the board
/Microcontroller/EMSW1: IC1.36 (PB2), J5.4
/Microcontroller/EMSW2: IC1.37 (PE7), J5.3
/Microcontroller/EMSW3: IC1.38 (PE8), J5.2
/Microcontroller/EMSW4: IC1.39 (PE9), J5.1
/Microcontroller/EMSw0: IC1.35 (PB1); also elsewhere on the board
/Microcontroller/EN45: IC1.92 (PB6); also elsewhere on the board
/Microcontroller/EN123: IC1.93 (PB7); also elsewhere on the board
/Microcontroller/ENC_TImer1A: IC1.67 (PA8), R1.1; also elsewhere on the board
/Microcontroller/ENC_TImer1B: IC1.68 (PA9); also elsewhere on the board
/Microcontroller/ENC_TImer2A: IC1.77 (PA15); also elsewhere on the board
/Microcontroller/ENC_TImer2B: IC1.89 (PB3); also elsewhere on the board
/Microcontroller/ENC_TImer2I: IC1.69 (PA10); also elsewhere on the board
/Microcontroller/ENC_TImer3A: IC1.90 (PB4); also elsewhere on the board
/Microcontroller/ENC_TImer3B: IC1.91 (PB5); also elsewhere on the board
/Microcontroller/ENC_TImer4A: IC1.59 (PD12); also elsewhere on the board
/Microcontroller/ENC_TImer4B: IC1.60 (PD13); also elsewhere on the board
/Microcontroller/ENC_TImer5A: IC1.22 (PA0), R7.2; also elsewhere on the board
/Microcontroller/ENC_TImer5B: IC1.23 (PA1), R8.1; also elsewhere on the board
/Microcontroller/ENC_TImer8A: IC1.63 (PC6); also elsewhere on the board
/Microcontroller/ENC_TImer8B: IC1.64 (PC7); also elsewhere on the board
/Microcontroller/Griper0: IC1.32 (PC4); also elsewhere on the board
/Microcontroller/HSE_I: C12.1, IC1.12 (PH0-OSC_IN), Y1.1
/Microcontroller/HSE_O: C13.1, IC1.13 (PH1-OSC_OUT), Y1.3
/Microcontroller/LED1: IC1.66 (PC9), R3.1
/Microcontroller/LED2: IC1.65 (PC8), R4.1
/Microcontroller/LED3: IC1.62 (PD15), R5.1
/Microcontroller/LED4: IC1.61 (PD14), R6.1
/Microcontroller/Logic Converter/Grpier1: R7.1; also elsewhere on the board
/Microcontroller/Logic Converter/Grpier2: R8.2; also elsewhere on the board
/Microcontroller/NRST: C14.1, IC1.14 (NRST), J2.4, SW1.2
/Microcontroller/OE: IC1.5 (PE6); also elsewhere on the board
/Microcontroller/RX: IC1.51 (PB12); also elsewhere on the board
/Microcontroller/RX1: IC1.54 (PB15), J1.1
/Microcontroller/RX3: IC1.56 (PD9), J2.5
/Microcontroller/SCL: IC1.46 (PB10); also elsewhere on the board
/Microcontroller/SDA: IC1.47 (PB11); also elsewhere on the board
/Microcontroller/SS_ENC1: IC1.86 (PD5), J16.6
/Microcontroller/SS_ENC2: IC1.85 (PD4), J16.5
/Microcontroller/SS_ENC3: IC1.84 (PD3), J16.4
/Microcontroller/SS_ENC4: IC1.83 (PD2), J16.3
/Microcontroller/SS_ENC5: IC1.82 (PD1), J16.2
/Microcontroller/SS_ENC6: IC1.81 (PD0), J16.1
/Microcontroller/STEP1: IC1.30 (PA6); also elsewhere on the board
/Microcontroller/STEP2: IC1.31 (PA7); also elsewhere on the board
/Microcontroller/STEP3: IC1.4 (PE5); also elsewhere on the board
/Microcontroller/STEP4: IC1.95 (PB8); also elsewhere on the board
/Microcontroller/STEP5: IC1.96 (PB9); also elsewhere on the board
/Microcontroller/SWCLK: IC1.76 (PA14), J2.1
/Microcontroller/SWDIO: IC1.72 (PA13), J2.3
/Microcontroller/TX: IC1.52 (PB13); also elsewhere on the board
/Microcontroller/TX1: IC1.53 (PB14), J1.2
/Microcontroller/TX3: IC1.55 (PD8), J2.7
/Microcontroller/USB_D+: IC1.71 (PA12)
/Microcontroller/USB_D-: IC1.70 (PA11)
GND: C1.2, C2.2, C3.2, C4.2, C5.2, C6.2, C7.2, C8.2, C9.2, C10.2, C11.2, C12.2, C13.2, C14.2, C15.2, C16.2, D1.3 (VSS), D2.1 (K), D3.1 (K), D4.1 (K), D5.1 (K), D6.1 (K), D7.3 (VSS), D8.3 (VSS), IC1.10 (VSS_1), IC1.19 (VSSA), IC1.26 (VSS_2), IC1.49 (VSS_3), IC1.74 (VSS_4), IC1.99 (VSS_5), J1.3, J2.6, JP1.1 (A), SW1.1, Y1.2, Y1.4; also elsewhere on the board
unnamed: C15.1, IC1.48 (VCAP_1)
unnamed: C16.1, IC1.73 (VCAP_2)
unnamed: D1.2 (DOUT), D7.4 (DIN)
unnamed: D1.4 (DIN), R1.2
unnamed: D2.2 (A), R2.2
unnamed: D3.2 (A), R3.2
unnamed: D4.2 (A), R4.2
unnamed: D5.2 (A), R5.2
unnamed: D6.2 (A), R6.2
unnamed: D7.2 (DOUT), D8.4 (DIN)
unnamed: JP1.2 (C), R9.1

Notes on the sheet:
LED
Reset Switch
DNI
RGB LED
Boot0
Programing Port
UART
Microcontroller
MCU Power Filter
