TsBeNz/Narwhal-Robot-Embedded-Systems/Board/NarwhelMainV2/NarwhelMainV2.kicad_pcb

## KiCad design Board/NarwhelMainV2/NarwhelMainV2.kicad_pcb (continued)

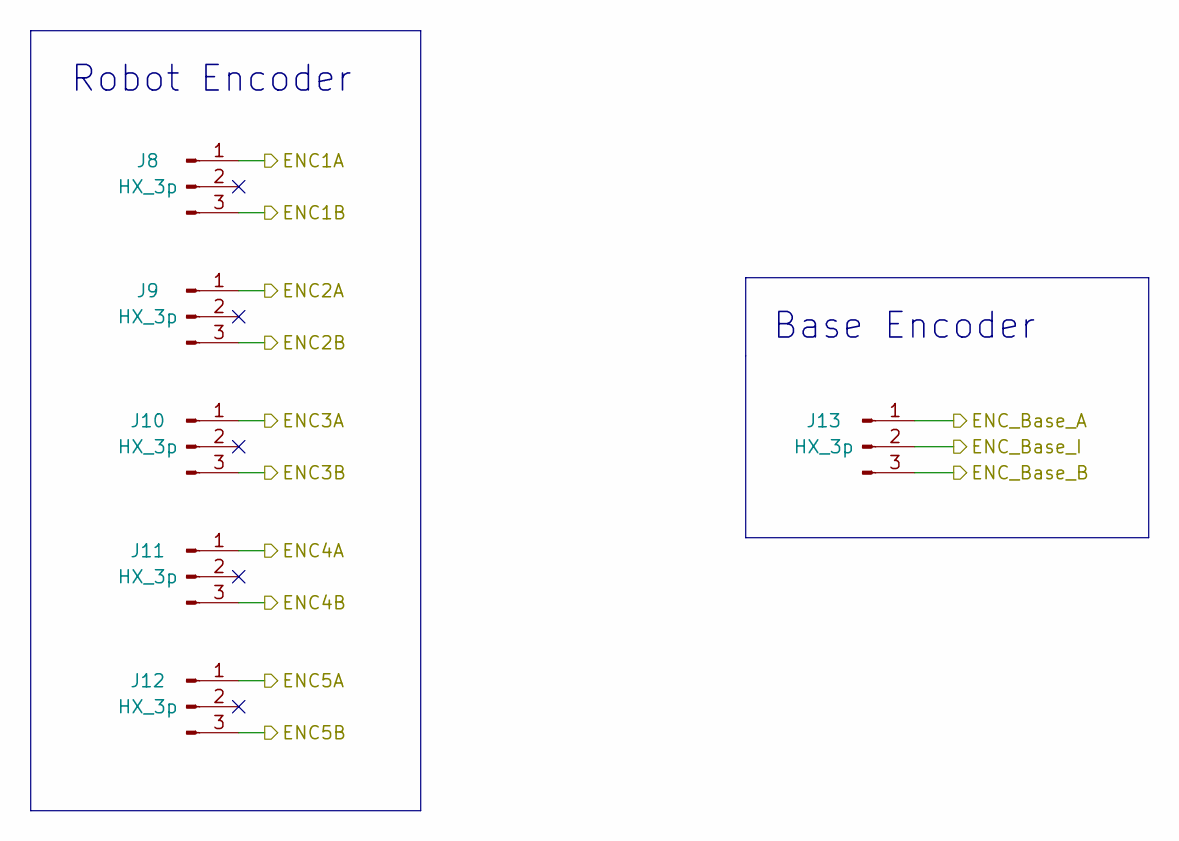
[picture p22: schematic ENC.kicad_sch]

Parts:
J8, J9, J10, J11, J12, J13: HX_3p; JST_XH_B3B-XH-A_1x03_P2.50mm_Vertical

Connections:
/Microcontroller/ENC_TImer1A: J11.1; also elsewhere on the board
/Microcontroller/ENC_TImer1B: J11.3; also elsewhere on the board
/Microcontroller/ENC_TImer2A: J13.1; also elsewhere on the board
/Microcontroller/ENC_TImer2B: J13.3; also elsewhere on the board
/Microcontroller/ENC_TImer2I: J13.2; also elsewhere on the board
/Microcontroller/ENC_TImer3A: J12.1; also elsewhere on the board
/Microcontroller/ENC_TImer3B: J12.3; also elsewhere on the board
/Microcontroller/ENC_TImer4A: J9.1; also elsewhere on the board
/Microcontroller/ENC_TImer4B: J9.3; also elsewhere on the board
/Microcontroller/ENC_TImer5A: J8.1; also elsewhere on the board
/Microcontroller/ENC_TImer5B: J8.3; also elsewhere on the board
/Microcontroller/ENC_TImer8A: J10.1; also elsewhere on the board
/Microcontroller/ENC_TImer8B: J10.3; also elsewhere on the board

Notes on the sheet:
Base Encoder
Robot Encoder

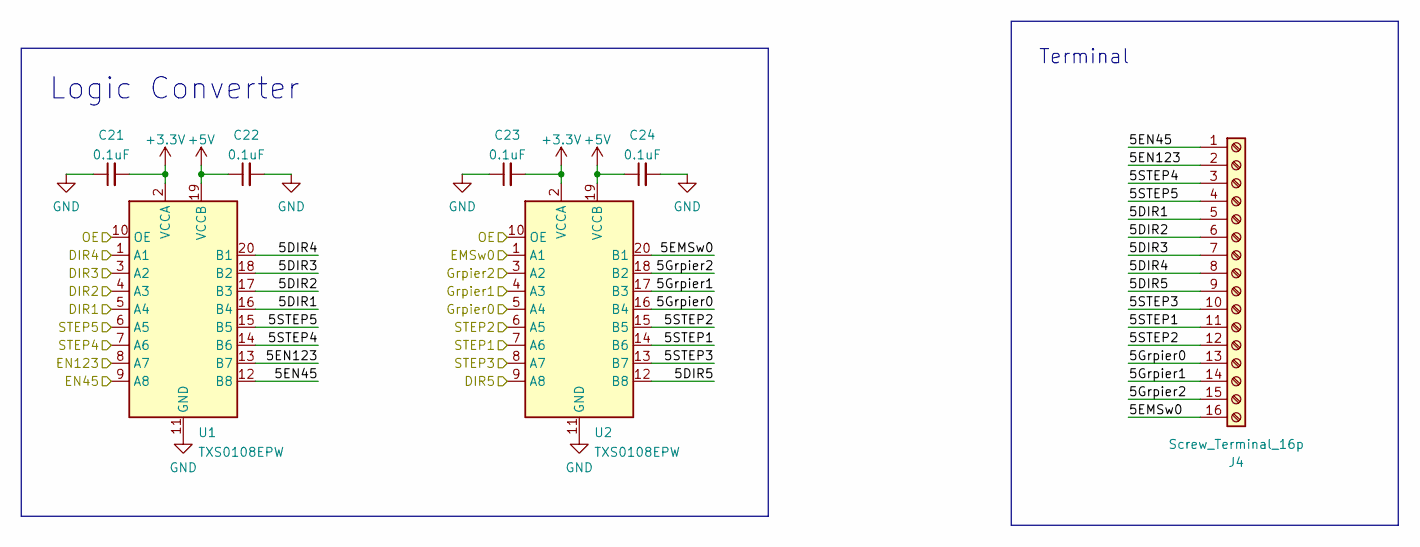
[picture p23: schematic Logic_Conv.kicad_sch]

Parts:
C21, C22, C23, C24: 0.1uF; C_0603_1608Metric_Pad1.08x0.95mm_HandSolder
J4: Screw_Terminal_16p; TerminalBlock_Phoenix_PT-1,5-16-3.5-H_1x16_P3.50mm_Horizont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
U1, U2: TXS0108EPW; TSSOP-20_4.4x6.5mm_P0.65mm

Connections:
+3V3: C21.2, C23.2, U1.2 (VCCA), U2.2 (VCCA); also elsewhere on the board
+5V: C22.1, C24.1, U1.19 (VCCB), U2.19 (VCCB); also elsewhere on the board
/Microcontroller/DIR1: U1.5 (A4); also elsewhere on the board
/Microcontroller/DIR2: U1.4 (A3); also elsewhere on the board
/Microcontroller/DIR3: U1.3 (A2); also elsewhere on the board
/Microcontroller/DIR4: U1.1 (A1); also elsewhere on the board
/Microcontroller/DIR5: U2.9 (A8); also elsewhere on the board
/Microcontroller/EMSw0: U2.1 (A1); also elsewhere on the board
/Microcontroller/EN45: U1.9 (A8); also elsewhere on the board
/Microcontroller/EN123: U1.8 (A7); also elsewhere on the board
/Microcontroller/Griper0: U2.5 (A4); also elsewhere on the board
/Microcontroller/Logic Converter/5DIR1: J4.5, U1.16 (B4)
/Microcontroller/Logic Converter/5DIR2: J4.6, U1.17 (B3)
/Microcontroller/Logic Converter/5DIR3: J4.7, U1.18 (B2)
/Microcontroller/Logic Converter/5DIR4: J4.8, U1.20 (B1)
/Microcontroller/Logic Converter/5DIR5: J4.9, U2.12 (B8)
/Microcontroller/Logic Converter/5EMSw0: J4.16, U2.20 (B1)
/Microcontroller/Logic Converter/5EN45: J4.1, U1.12 (B8)
/Microcontroller/Logic Converter/5EN123: J4.2, U1.13 (B7)
/Microcontroller/Logic Converter/5Grpier0: J4.13, U2.16 (B4)
/Microcontroller/Logic Converter/5Grpier1: J4.14, U2.17 (B3)
/Microcontroller/Logic Converter/5Grpier2: J4.15, U2.18 (B2)
/Microcontroller/Logic Converter/5STEP1: J4.11, U2.14 (B6)
/Microcontroller/Logic Converter/5STEP2: J4.12, U2.15 (B5)
/Microcontroller/Logic Converter/5STEP3: J4.10, U2.13 (B7)
/Microcontroller/Logic Converter/5STEP4: J4.3, U1.14 (B6)
/Microcontroller/Logic Converter/5STEP5: J4.4, U1.15 (B5)
/Microcontroller/Logic Converter/Grpier1: U2.4 (A3); also elsewhere on the board
/Microcontroller/Logic Converter/Grpier2: U2.3 (A2); also elsewhere on the board
/Microcontroller/OE: U1.10 (OE), U2.10 (OE); also elsewhere on the board
/Microcontroller/STEP1: U2.7 (A6); also elsewhere on the board
/Microcontroller/STEP2: U2.6 (A5); also elsewhere on the board
/Microcontroller/STEP3: U2.8 (A7); also elsewhere on the board
/Microcontroller/STEP4: U1.7 (A6); also elsewhere on the board
/Microcontroller/STEP5: U1.6 (A5); also elsewhere on the board
GND: C21.1, C22.2, C23.1, C24.2, U1.11 (GND), U2.11 (GND); also elsewhere on the board

Notes on the sheet:
Logic Converter
Terminal

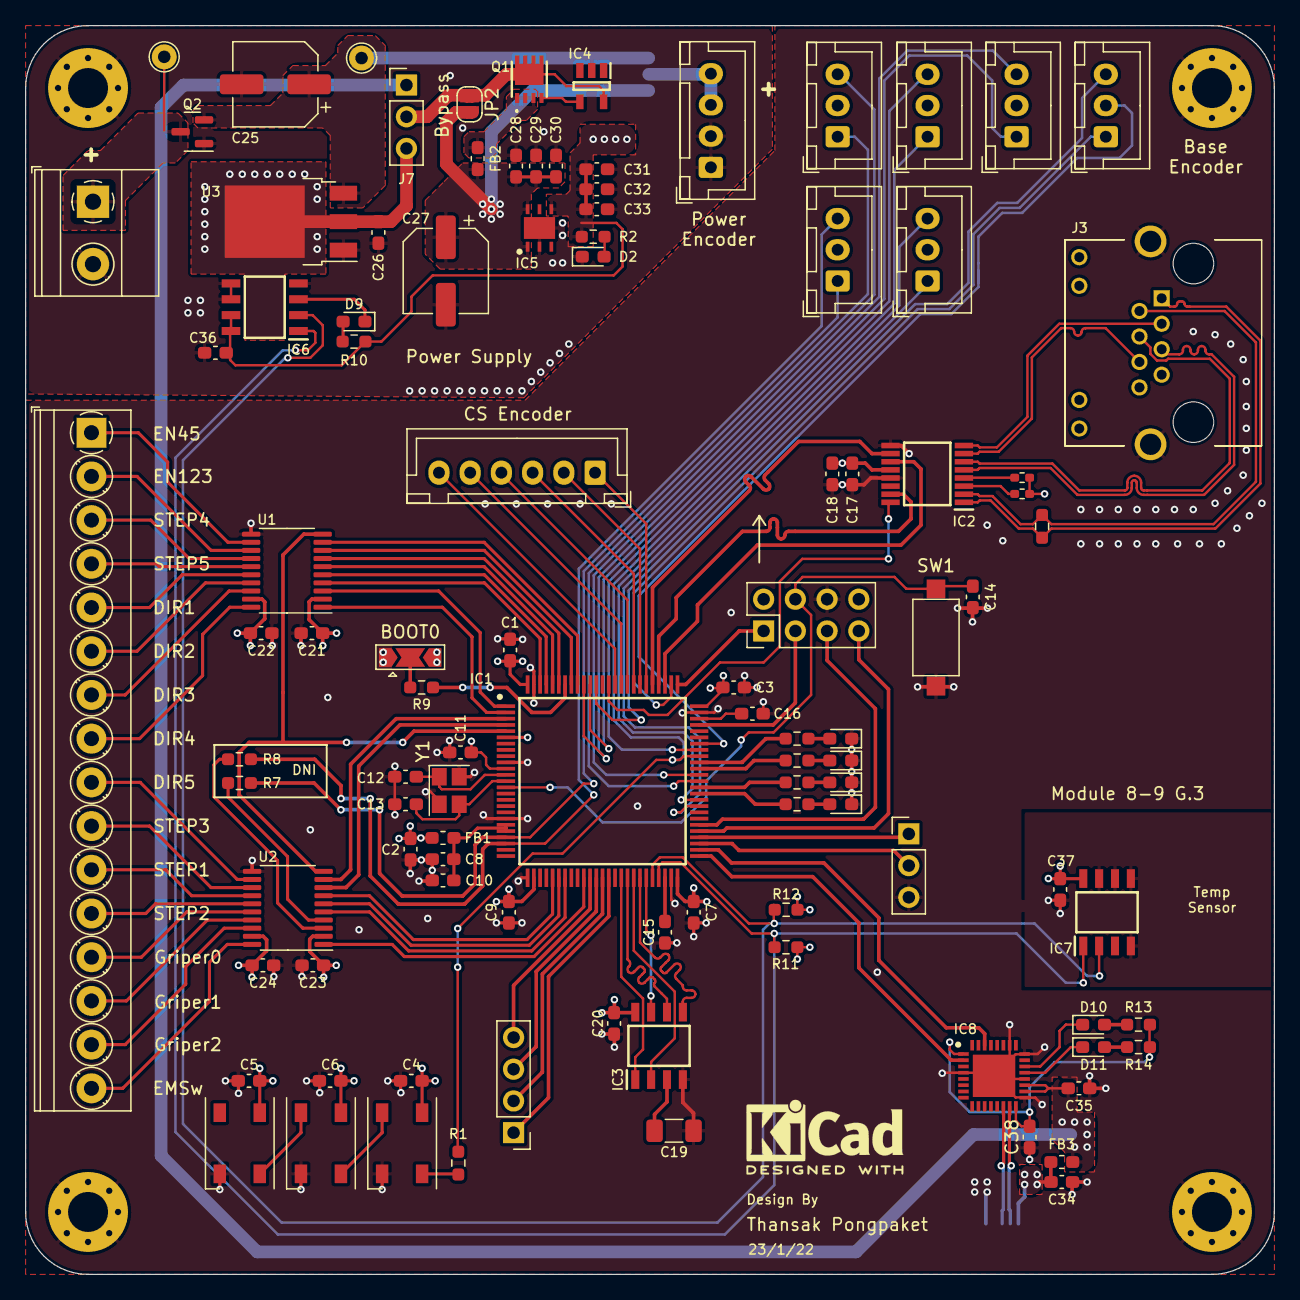
[picture p24: board NarwhelMainV2.kicad_pcb from above]

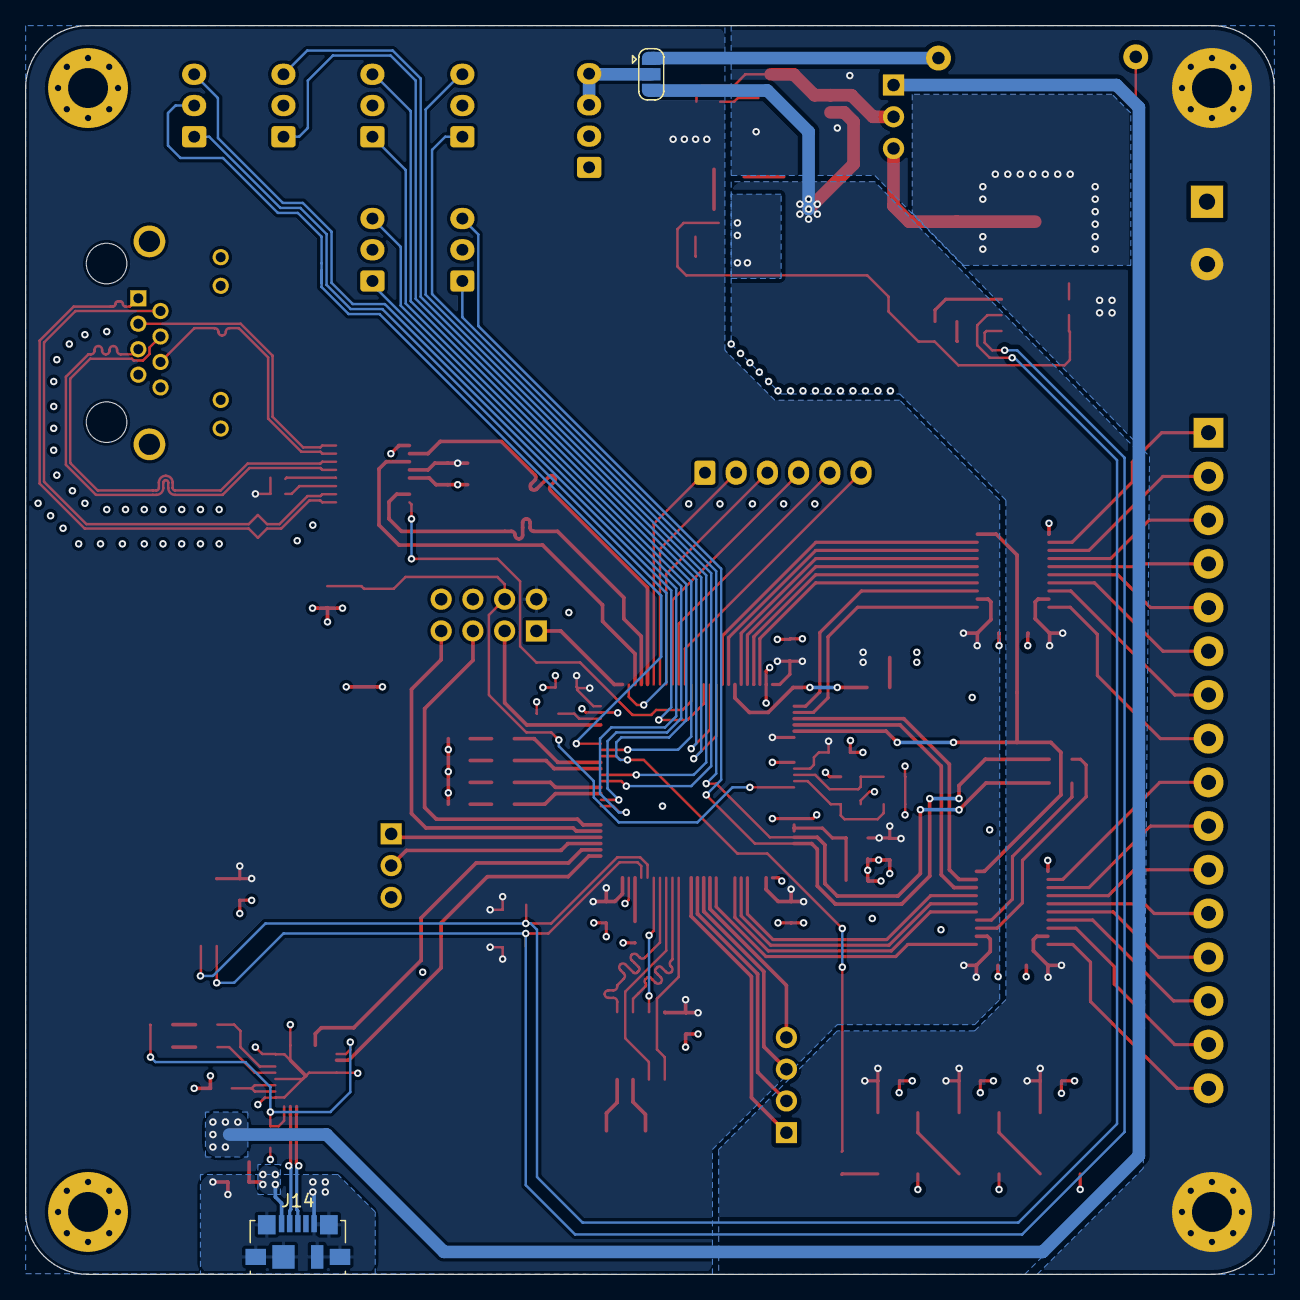
[picture p25: board NarwhelMainV2.kicad_pcb from below]

Board: 4 copper layers, 100.0 x 100.0 mm, 109 parts (2 on the bottom side), 125 nets.
