TsBeNz/Narwhal-Robot-Embedded-Systems/LowLevel_Code/Master_Config_STM32H733/Core/Src/main.c

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
/* Includes ------------------------------------------------------------------*/
#include "main.h"
#include "adc.h"
#include "crc.h"
#include "dma.h"
#include "i2c.h"
#include "spi.h"
#include "tim.h"
#include "usart.h"
#include "gpio.h"

/* USER CODE BEGIN Includes */
#include <math.h>
#include "kinematics.h"
#include "control.h"
#include "AS5047U.h"
#include "Neopixel.h"
//#include "TPM75.h"
#include "Tmp75.h"

//#include "arm_math.h"
/* USER CODE END Includes */

/* USER CODE BEGIN PD */

/*   Module 8-9 Variable Section   */


double Z_TopOffset = 180;
double Z_2GripOffset = 50;

double Task2ShowinMonitor[3];
uint8_t Servo_Griper[2];


double Temperature;
double Temp_Calibration;

typedef enum
{
	Chess_idle,
	Move_2_Start_Top_Point,
	Move_2_Start_Grip_Point,
	Move_2_Start_Point_and_Griping,
	Back_2_Start_Top_Point,
	Move_2_End_Top_Point,
	Move_2_End_Ungrip_Point,
	Move_2_End_Remove_Point_and_Ungriping,
	Move_2_End_Point_and_Ungriping,
	Back_2_End_Top_Point,
	ChessMove_Finish,
} ChessMoveState;

/*  Library */
AS5047U Encoder[4];
KalmanParameter Kalman[5];
ControlParameter Control[4];
SteperParameter Stepper[4];
ServoParameter Servo[2];
NeopixelParameter Neopixel;
TrajParameter Traj[7]; /* index 0-3 is joint Traj and 4 is Z axis Traj */

double Chess_Board_Base_Encoder = 0;
uint16_t BaseENC[2] = {0,0};

double TPM75_Temp;

double SetPoint_Position[5];
double SetPoint_Velocity[5];
double t;

/*   Flag   */
uint8_t Contorl_Flag;
uint8_t Traj_Flag;
uint8_t Protocol_Flag;
uint8_t Chessmove_State;
uint8_t Trajz_Flag;

/*	Software Timer	*/
uint32_t Software_Timer_1s;
uint32_t Software_Timer_100ms;

uint8_t UART5_rxBuffer[14] __attribute__((section("RAM_D2"))) = {0};
uint8_t UART5_txBuffer[45] __attribute__((section("RAM_D2"))) = {0};
uint8_t Comunication_Heartbeat = 0;
uint8_t ChessIndex[2];
float ChessHight;
uint8_t Chess_Move_Start_Flag = 0;
ChessMoveState ChessMoveStates = Chess_idle;
uint8_t PositionX_Remove = 0;

double tune_PID[2] = {0,0};
double T_tune_PID = 2;


/*	Jog Variable	*/
double JointTrajSet[4];
double TaskTrajSet[3];

uint8_t traj_finish = 0;
double traj_t_set[4];
double t,T_Traj;

double pos,vel,dt_test,f_out,position_test;
uint16_t reg_out;
double v2freqGain;

uint8_t Buffer_TPM75[2];

// Debug Variable //


uint8_t Test_traj = 0;
uint8_t Test_traj2 = 0;
double Test_traj_Val[4];
double Time_Live_Ex1 = 2;
double TaskSpace_Live_Ex1[3] ={0,0,0};


/*	ChessMove	*/
double EndEffectorTarget[3];

/* USER CODE END PD */


void SystemClock_Config(void);
void PeriphCommonClock_Config(void);
/* USER CODE BEGIN PFP */

//uint8_t crc_uart(void);
//void Uart1_Sent(void);

uint8_t CRC8(uint8_t *Data,uint8_t BufferLength);
void SentData(uint8_t range);
void Narwhal_Protocol();
void Control_Function();
void JMoveTaskSpace(double Task2Go[3], double Time2Move);
void LMoveTaskSpace(double Task2Go[3], double Time2Move);
void ChessNotMovePathWay(uint8_t Index2Move, double Z_Offset, uint8_t IsJMove, uint8_t IsRemove);
void ChessMoveStateMachine();
double All_Joint_Speed_Avg();

/* USER CODE END PFP */

/**
  * @brief  The application entry point.
  * @retval int
  */
int main(void)
{
  /* MCU Configuration--------------------------------------------------------*/

  /* Reset of all peripherals, Initializes the Flash interface and the Systick. */
  HAL_Init();

  /* Configure the system clock */
  SystemClock_Config();

/* Configure the peripherals common clocks */
  PeriphCommonClock_Config();

  /* USER CODE BEGIN SysInit */
  MX_DMA_Init();
  /* USER CODE END SysInit */

  /* Initialize all configured peripherals */
  MX_GPIO_Init();
  MX_DMA_Init();
  MX_ADC3_Init();
  MX_TIM1_Init();
  MX_TIM3_Init();
  MX_TIM4_Init();
  MX_TIM5_Init();
  MX_TIM8_Init();
  MX_TIM13_Init();
  MX_TIM14_Init();
  MX_TIM15_Init();
  MX_TIM16_Init();
  MX_TIM17_Init();
  MX_USART1_UART_Init();
  MX_USART3_UART_Init();
  MX_SPI3_Init();
  MX_SPI4_Init();
  MX_I2C2_Init();
  MX_CRC_Init();
  MX_TIM24_Init();
  MX_TIM23_Init();
  MX_TIM6_Init();
  MX_UART5_Init();
  MX_ADC1_Init();
  MX_ADC2_Init();
  MX_TIM2_Init();
  /* USER CODE BEGIN 2 */
	HAL_GPIO_WritePin(GPIOD, GPIO_PIN_6, 1);	// LVDS EN
	HAL_GPIO_WritePin(GPIOE, GPIO_PIN_6, 1);	// Level Shifter EN

	Temp_Calibration =
			(110.0 - 30.0)
					/ (*(unsigned short*) (0x1FF1E840)
							- *(unsigned short*) (0x1FF1E820));
	HAL_ADCEx_Calibration_Start(&hadc3, ADC_CALIB_OFFSET, ADC_SINGLE_ENDED);

	/*			   Encoder				*/
	AS5047U_init(&Encoder[0], &hspi3, GPIOD, &hcrc, GPIO_PIN_0, 6500);
	AS5047U_init(&Encoder[1], &hspi3, GPIOD, &hcrc, GPIO_PIN_1, 10100);
	AS5047U_init(&Encoder[2], &hspi3, GPIOD, &hcrc, GPIO_PIN_2, 3165);
	AS5047U_init(&Encoder[3], &hspi3, GPIOD, &hcrc, GPIO_PIN_3, 6970);

	HAL_Delay(50);

	/* Encoder ABI Res Setting */
	AS5047U_Write(&Encoder[0], 0x001A, 0b01000000);
	AS5047U_Write(&Encoder[1], 0x001A, 0b01000000);
	AS5047U_Write(&Encoder[2], 0x001A, 0b01000000);
	AS5047U_Write(&Encoder[3], 0x001A, 0b01000000);

	/* Chess Board Encoder */
	HAL_TIM_Encoder_Start(&htim2, TIM_CHANNEL_ALL);

	/*			Kalman Filter			*/
	Kalman_init(&Kalman[0], 5000, 0.001);
	Kalman_init(&Kalman[1], 5000, 0.001);
	Kalman_init(&Kalman[2], 5000, 0.001);
	Kalman_init(&Kalman[3], 5000, 0.001);
	Kalman_init(&Kalman[5], 5000, 0.001);

	/*			CascadeControl			*/
	CascadeControl_init(&Control[0], 0.75, 0, 0, 15, 0.5, 10, 400);
	CascadeControl_init(&Control[1], 0.5, 0, 0.5, 10, 0, 30, 410);
	CascadeControl_init(&Control[2], 0.5, 0, 0.3, 25, 0, 30, 800);
	CascadeControl_init(&Control[3], 0.75, 0, 0.3, 9, 0, 3, 420);

	/*  Power Supply Temperature Sensor */
	Tmp75_Init(&hi2c2);

	SetPoint_Position[0] = EncPulse2Rad_Read(&Encoder[0], 1);
	SetPoint_Position[1] = EncPulse2Rad_Read(&Encoder[1], 0);
	SetPoint_Position[2] = EncPulse2Rad_Read(&Encoder[2], 0);
	SetPoint_Position[3] = EncPulse2Rad_Read(&Encoder[3], 0);
	SetPoint_Velocity[0] = 0;
	SetPoint_Velocity[1] = 0;
	SetPoint_Velocity[2] = 0;
	SetPoint_Velocity[3] = 0;

	/*			Stepper Driver			*/
	Step_Driver_init(&Stepper[0], &htim13, TIM_CHANNEL_1, GPIOE, GPIO_PIN_0, 500000, 1);
	Step_Driver_init(&Stepper[1], &htim14, TIM_CHANNEL_1, GPIOE, GPIO_PIN_1, 500000, 0);
	Step_Driver_init(&Stepper[2], &htim15, TIM_CHANNEL_1, GPIOE, GPIO_PIN_2, 500000, 1);
	Step_Driver_init(&Stepper[3], &htim16, TIM_CHANNEL_1, GPIOE, GPIO_PIN_3, 500000, 1);

	/*         	  Servo             */
	Servo_init(&Servo[0], &htim3, TIM_CHANNEL_1);
	Servo_init(&Servo[1], &htim3, TIM_CHANNEL_2);
	Servo_Drive(&Servo[0], 90);
	Servo_Drive(&Servo[1], 90);

	/*			Trajectory			*/
	Test_traj_Val[0] = 0;
	Test_traj_Val[1] = 0;
	Test_traj_Val[2] = 0;
	Test_traj_Val[3] = 0;
	Traj_Flag = 0;
	t = 0;

	/*   RGB LED   */
	Neopixel_Init(&Neopixel, &htim1, TIM_CHANNEL_1);
	Neopixel_Set(&Neopixel, 0, 255, 0, 0);
	Neopixel_Set(&Neopixel, 1, 0, 255, 0);
	Neopixel_Set(&Neopixel, 2, 0, 0, 255);
	Neopixel_Sent(&Neopixel);

	HAL_TIM_Base_Start_IT(&htim23);   // Start Control Timer
	HAL_UART_Receive_IT(&huart5, UART5_rxBuffer, 14);
	ChessMoveStates = Chess_idle;

  /* USER CODE END 2 */

  /* Infinite loop */
  /* USER CODE BEGIN WHILE */
  while (1)
  {
    /* USER CODE END WHILE */

    /* USER CODE BEGIN 3 */
//		Servo_Drive(&Servo[0], Servo_Griper[0]);
//		Servo_Drive(&Servo[1], Servo_Griper[1]);

		if (Test_traj) {
			Test_traj = 0;
			JMoveTaskSpace(TaskSpace_Live_Ex1, Time_Live_Ex1);
		}
		if (Test_traj2) {
			Test_traj2 = 0;
			double TaskSpace_Live_Ex1_ChangeZ[3];
			TaskSpace_Live_Ex1_ChangeZ[0] = TaskSpace_Live_Ex1[0];
			TaskSpace_Live_Ex1_ChangeZ[1] = TaskSpace_Live_Ex1[1];
			TaskSpace_Live_Ex1_ChangeZ[2] = TaskSpace_Live_Ex1[2] - 100;
			JMoveTaskSpace(TaskSpace_Live_Ex1_ChangeZ, Time_Live_Ex1);
		}

	   uint8_t tune_joint = 3;
	   if (tune_PID[0] != tune_PID[1]){
		   	tune_PID[1] = tune_PID[0];
			t = 0;
			double Joint[4] = {0,0,0,0};
			for (int i = 0; i < 4; i++) {
				Joint[i] = Control[i].PositionFeedback;
			}
			Joint[tune_joint] = tune_PID[0];
			for (int i = 0; i < 4; i++) {
				Traj_Coeff_Cal(&Traj[i], T_tune_PID, Joint[i], Control[i].PositionFeedback,0, Control[i].VelocityFeedback);
			}
			Traj_Flag = 0x0F;
	   }

		if (Contorl_Flag) {
			Control_Function();
			Contorl_Flag = 0;    // Clear Control Flag
		}

		if (Protocol_Flag) {
			Narwhal_Protocol();
			Protocol_Flag = 0;
		}

		if (HAL_GetTick() - Software_Timer_100ms >= 10) {
			Software_Timer_100ms = HAL_GetTick();
			HAL_ADC_Start_IT(&hadc3); 				//	read temperature sensor
			One_ShotTemp(&hi2c2);
			Read_TempCelsius(&TPM75_Temp,&hi2c2);
			ChessMoveStateMachine();
		}

		if (HAL_GetTick() - Software_Timer_1s >= 1000) {		// 	Update System Status
			Software_Timer_1s = HAL_GetTick();
			HAL_GPIO_TogglePin(LED2_GPIO_Port, LED2_Pin);
			if (Comunication_Heartbeat == 0){
				HAL_GPIO_WritePin(LED3_GPIO_Port, LED3_Pin, 1);
			}
			else{
				Comunication_Heartbeat -= 1;
				HAL_GPIO_WritePin(LED3_GPIO_Port, LED3_Pin, 0);
			}
		}
	}
  /* USER CODE END 3 */
}

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
/* USER CODE BEGIN 4 */

void HAL_UART_RxCpltCallback(UART_HandleTypeDef *huart) {
	if (huart == &huart5) {
		Protocol_Flag = 1;
	}
}

void HAL_TIM_PWM_PulseFinishedCallback(TIM_HandleTypeDef *htim) {
	HAL_TIM_PWM_Stop_DMA(&htim1, TIM_CHANNEL_1);
}

void HAL_ADC_ConvCpltCallback(ADC_HandleTypeDef *hadc) {
	if (hadc == &hadc3) {
		uint32_t ADC_Output = HAL_ADC_GetValue(&hadc3);
		Temperature = ((Temperature * 19)
				+ (Temp_Calibration
						* (double) ((double) ADC_Output
								- *(unsigned short*) (0x1FF1E820)) + 30.0f))
				/ 20;
	}
}

void HAL_TIM_PeriodElapsedCallback(TIM_HandleTypeDef *htim) {
	if (htim == &htim23) {
		Contorl_Flag = 1;
	}
}

inline uint8_t CRC8(uint8_t *Data,uint8_t BufferLength){
	return HAL_CRC_Calculate(&hcrc, (uint32_t*) Data, BufferLength) ^ 0xFF;
}
inline void SentData(uint8_t range){
	UART5_txBuffer[range] = CRC8(UART5_txBuffer, range);
	HAL_UART_Transmit_IT(&huart5, UART5_txBuffer, range+1);
}

inline void Narwhal_Protocol() {
	if (UART5_rxBuffer[0] == 0xFF) {
		uint8_t CRC_Cal = CRC8(UART5_rxBuffer, 13);
		if (CRC_Cal == UART5_rxBuffer[13]) {
			UART5_txBuffer[0] = 0xFF;
			Comunication_Heartbeat = 2;
			double Safe_Zone[4] = { 0, 0.5, -0.5, 0 };
			double q_Feed[4];
			double dq[4];
			double d_Task[3];
			double d_Task_Set[3];
			double q_in[5] = {0,0,0,0,0};
			double q_in_Set[5] = {0,0,0,0,0};
			double task[3] = { 0, 0, 0 };
			int Chess_Board_Base_Encoder2Sent;


			uint16_t Temperature_Protocol = Temperature * 1000;
			uint16_t Temperature_Protocol2 = TPM75_Temp * 1000;

			/* 		Data to MCU Start	*/
			switch (UART5_rxBuffer[1]) {
			case 0xF0:
				/* Ping */
				UART5_txBuffer[2] = 0x00;
				UART5_txBuffer[1] = 0xFF;
				SentData(3);
				break;
			case 0xF1:
				/* Working Mode Set */
				UART5_txBuffer[2] = 0x01;
				UART5_txBuffer[1] = 0xFF;
				SentData(3);
				break;
			case 0xF5:
				/* GoHome */
				if (Traj_Flag == 0) {;
					t = 0;
					for (int i = 0; i < 4; i++) {
						Traj_Coeff_Cal(&Traj[i], 2, 0,
								Control[i].PositionFeedback, 0,
								Control[i].VelocityFeedback);
					}
					Traj_Flag = 0x0F;
					Chessmove_State = 0;
					UART5_txBuffer[2] = 0x00;
				} else {
					UART5_txBuffer[2] = 0x01;
				}
				UART5_txBuffer[1] = 0xFF;
				SentData(3);
				break;
			case 0xF6:
				/* GoSafe */
				if (Traj_Flag == 0) {
					;
					t = 0;
					for (int i = 0; i < 4; i++) {
						Traj_Coeff_Cal(&Traj[i], 2.5, Safe_Zone[i],
								Control[i].PositionFeedback, 0,
								Control[i].VelocityFeedback);
					}
					Traj_Flag = 0x0F;
					Chessmove_State = 0;
					UART5_txBuffer[2] = 0x00;
				} else {
					UART5_txBuffer[2] = 0x01;
				}
				UART5_txBuffer[1] = 0xFF;
				SentData(3);
				break;
			case 0xF7:
				/* Set0 BaseEnc */
				Chess_Board_Base_Encoder = 0;
				UART5_txBuffer[1] = 0xFF;
				SentData(3);
				break;
			case 0xFA:
				/* Joint Jog */
				t = 0;
				for (int i = 0; i < 4; i++) {
					double JointJog = (int16_t) (((UART5_rxBuffer[2 + (2 * i)])
							<< 8) | (UART5_rxBuffer[3 + (2 * i)])) / 1000.0;
					Traj_Coeff_Cal(&Traj[i], 0.5,
							JointJog + Control[i].PositionFeedback,
							Control[i].PositionFeedback, 0,
							Control[i].VelocityFeedback);
				}
				Traj_Flag = 0x0F;
				Chessmove_State = 0;
				UART5_txBuffer[2] = 0x00;
				UART5_txBuffer[1] = 0xFF;
				SentData(3);
				break;
			case 0xFB:
				/* Cartesian Jog */
				q_Feed[0] = Control[0].PositionFeedback;
				q_Feed[1] = Control[1].PositionFeedback;
				q_Feed[2] = Control[2].PositionFeedback;
				q_Feed[3] = Control[3].PositionFeedback;
				for (int i = 0; i < 3; i++) {
					d_Task[i] = (int16_t) (((UART5_rxBuffer[2 + (2 * i)]) << 8)
							| (UART5_rxBuffer[3 + (2 * i)])) / 50.0;
				}
				IVK(q_Feed, d_Task, dq);
				t = 0;
				for (int i = 0; i < 4; i++) {
					double Setpoint = Control[i].PositionFeedback + dq[i];
					Traj_Coeff_Cal(&Traj[i], 0.5, Setpoint,
							Control[i].PositionFeedback, 0,
							Control[i].VelocityFeedback);
				}
				Traj_Flag = 0x0F;
				Chessmove_State = 0;
				UART5_txBuffer[2] = 0x00;
				UART5_txBuffer[1] = 0xFF;
				SentData(3);
				break;
			case 0xFD:
				/* Joint Set */
				t = 0;
				double Joint[4];
				double T = 1;
				double Distance = -1;
				for (int i = 0; i < 4; i++) {
					Joint[i] = (int16_t) (((UART5_rxBuffer[2 + (2 * i)]) << 8)
							| (UART5_rxBuffer[3 + (2 * i)])) / 1000.0;
					if (Joint[i] > Distance){
						Distance = Joint[i];
					}
				}
				T += (Distance * 0.8);
				for (int i = 0; i < 4; i++) {
					Traj_Coeff_Cal(&Traj[i], T, Joint[i],
							Control[i].PositionFeedback, 0,
							Control[i].VelocityFeedback);
				}
				Traj_Flag = 0x0F;
				Chessmove_State = 0;
				UART5_txBuffer[2] = 0x03;
				UART5_txBuffer[1] = 0xFF;
				SentData(3);
				break;
			case 0xFE:
				/* Cartesian Set */
				t = 0;
				double Task[3];
				for (int i = 0; i < 3; i++) {
					Task[i] = (int16_t) (((UART5_rxBuffer[2 + (2 * i)]) << 8)
							| (UART5_rxBuffer[3 + (2 * i)])) / 50.0;
				}
				double q_Feed[4];
				double Pne[3];
				q_Feed[0] = Control[0].PositionFeedback;
				q_Feed[1] = Control[1].PositionFeedback;
				q_Feed[2] = Control[2].PositionFeedback;
				q_Feed[3] = Control[3].PositionFeedback;

				FPK(q_Feed, 269.0f, Pne);
				double Time2MoveDynamic = 1.3;
				Time2MoveDynamic += (sqrt(
						((Task[0] - Pne[0]) * (Task[0] - Pne[0]))
								+ ((Task[1] - Pne[1]) * (Task[1] - Pne[1]))
								+ ((Task[2] - Pne[2]) * (Task[2] - Pne[2]))))
						* 0.0075;

				JMoveTaskSpace(Task, Time2MoveDynamic);
				UART5_txBuffer[2] = 0x00;
				UART5_txBuffer[1] = 0xFF;
				SentData(3);
				break;
			case 0xFF:
				/* Chess Move */
//				uint8_t ChessIndex[2];
				for (int i = 0; i < 2; i++) {
					ChessIndex[i] = (uint8_t) (UART5_rxBuffer[2 + i]);
				}
				ChessHight = (float)(((UART5_rxBuffer[4]) << 8)
						| (UART5_rxBuffer[5])) / 100.0f;

				if (ChessIndex[0] == 65 || ChessIndex[1] == 65){
					ChessMoveStates = ChessMove_Finish;
					PositionX_Remove = 0;
				}

				Chess_Move_Start_Flag = 1;
				UART5_txBuffer[2] = 0x05;
				UART5_txBuffer[1] = 0xFF;
				SentData(3);
				break;
				/* 		Data to MCU End	*/

				/* 		Sent Data to Master Start 	*/
			case 0xA0:
				/* System Status */
				UART5_txBuffer[1] = 0xEE;
				UART5_txBuffer[2] = (uint8_t) ((Temperature_Protocol >> 8) & 0xFF);
				UART5_txBuffer[3] = (uint8_t) (Temperature_Protocol & 0xFF);
				SentData(4);
				break;
			case 0xA1:
				/* Station Encoder Position */
				UART5_txBuffer[1] = 0xEE;
				Chess_Board_Base_Encoder2Sent = (int)(Chess_Board_Base_Encoder * 1000.0f);
				UART5_txBuffer[2] = (uint8_t) ((Chess_Board_Base_Encoder2Sent >> 8) & 0xFF);
				UART5_txBuffer[3] = (uint8_t) (Chess_Board_Base_Encoder2Sent & 0xFF);
				SentData(4);
				break;
			case 0xA2:
				/* Raw Joint Encoder Position */
				UART5_txBuffer[1] = 0xEE;
				for (int i = 0; i < 4; i++) {
					UART5_txBuffer[2 + (2 * i)] = (uint8_t) ((Encoder[i].Position >> 8)
							& 0xFF);
					UART5_txBuffer[3 + (2 * i)] = (uint8_t) (Encoder[i].Position & 0xFF);
				}
				SentData(12);
				break;
			case 0xAA:
				/* Joint Position */
				UART5_txBuffer[1] = 0xEE;
				for (int i = 0; i < 4; i++) {
					int16_t Buf = (int16_t) (Control[i].PositionFeedback
							* 1000.0f);
					UART5_txBuffer[2 + (2 * i)] = (uint8_t) ((Buf >> 8) & 0xFF);
					UART5_txBuffer[3 + (2 * i)] = (uint8_t) (Buf & 0xFF);
				}
				UART5_txBuffer[10] = 0;
				UART5_txBuffer[11] = 0;
				SentData(12);
				break;
			case 0xAB:
				/* Task Space Position */
				UART5_txBuffer[1] = 0xEE;
				/*	Forward Kinematics */

				for (int i = 0; i < 4; i++) {
					q_in[i] = Control[i].PositionFeedback;
				}
				FPK(q_in, 269.0f, task);

				for (int i = 0; i < 3; i++) {
					int16_t Buf = (int16_t) (task[i] * 10.0f);
					UART5_txBuffer[2 + (2 * i)] = (uint8_t) ((Buf >> 8) & 0xFF);
					UART5_txBuffer[3 + (2 * i)] = (uint8_t) (Buf & 0xFF);
				}
				SentData(8);
				break;
			case 0xAF:
				/* UI Feedback */
				UART5_txBuffer[1] = 0xEE;
				/*	Forward Kinematics */
				for (int i = 0; i < 4; i++) {
					q_in[i] = Control[i].PositionFeedback;
				}
				for (int i = 0; i < 4; i++) {
					q_in_Set[i] = Control[i].PositionSetpoint;
				}
				FPK(q_in, 269.0f, task);
				FPK(q_in_Set, 269.0f, d_Task_Set);

				/* Station Encoder */
				Chess_Board_Base_Encoder2Sent = Chess_Board_Base_Encoder * 1000.0f;
				UART5_txBuffer[2] = (uint8_t) ((Chess_Board_Base_Encoder2Sent >> 8) & 0xFF);
				UART5_txBuffer[3] = (uint8_t) (Chess_Board_Base_Encoder2Sent & 0xFF);

				/* Temp */
				UART5_txBuffer[4] = (uint8_t) ((Temperature_Protocol >> 8) & 0xFF);
				UART5_txBuffer[5] = (uint8_t) (Temperature_Protocol & 0xFF);
				UART5_txBuffer[6] = (uint8_t) ((Temperature_Protocol2 >> 8) & 0xFF);
				UART5_txBuffer[7] = (uint8_t) (Temperature_Protocol2 & 0xFF);

				/* Joint Current */
				for (int i = 0; i < 4; i++) {
					int16_t Buf = (int16_t) (Control[i].PositionFeedback
							* 1000.0f);
					UART5_txBuffer[8 + (2 * i)] = (uint8_t) ((Buf >> 8) & 0xFF);
					UART5_txBuffer[9 + (2 * i)] = (uint8_t) (Buf & 0xFF);
				}
				UART5_txBuffer[16] = 0;
				UART5_txBuffer[17] = 0;

				/* Joint Set point*/
				for (int i = 0; i < 4; i++) {
					int16_t Buf = (int16_t) (SetPoint_Position[i] * 1000.0f);
					UART5_txBuffer[18 + (2 * i)] = (uint8_t) ((Buf >> 8) & 0xFF);
					UART5_txBuffer[19 + (2 * i)] = (uint8_t) (Buf & 0xFF);
				}
				UART5_txBuffer[26] = 0;
				UART5_txBuffer[27] = 0;

				for (int i = 0; i < 3; i++) {
					int16_t Buf = (int16_t) (task[i] * 10.0f);
					UART5_txBuffer[28 + (2 * i)] = (uint8_t) ((Buf >> 8) & 0xFF);
					UART5_txBuffer[29 + (2 * i)] = (uint8_t) (Buf & 0xFF);
				}
				UART5_txBuffer[34] = Chess_Move_Start_Flag;
				for (int i = 0; i < 3; i++) {
					int16_t Buf = (int16_t) (d_Task_Set[i] * 10.0f);
					UART5_txBuffer[35 + (2 * i)] = (uint8_t) ((Buf >> 8) & 0xFF);
					UART5_txBuffer[36 + (2 * i)] = (uint8_t) (Buf & 0xFF);
				}
				SentData(41);
				break;
			default:
				UART5_txBuffer[2] = 0xFF;
				SentData(3);
				/* 		Sent Data to Master End 	*/
			}
		} else {
			/*		CRC Error		*/
			UART5_txBuffer[1] = 0xCC;
			SentData(3);
		}
	} else {
		/*		Header Error	*/
		UART5_txBuffer[1] = 0xAA;
		SentData(3);
	}
	HAL_UART_Receive_IT(&huart5, UART5_rxBuffer, 14);
}

inline void JointSpaceTraj(double Task2Move[3],double Time2Move){
	double gamma[3] = {1,1,-1};
	double q_inv[4];
	IPK(gamma, Task2Move, q_inv);
	t = 0;
	for (int i = 0; i < 4; i++) {
		Traj_Coeff_Cal(&Traj[i], Time2Move, q_inv[i],
				Control[i].PositionFeedback,  0,
				Control[i].VelocityFeedback);
	}
	Traj_Flag = 0x0F;
	Chessmove_State = 0;
}

inline void Control_Function() {
	/***** Encoder Read *****/
	double J1, J2, J3, J4;
	J1 = EncPulse2Rad_Read(&Encoder[0], 1);
	J2 = EncPulse2Rad_Read(&Encoder[1], 0);
	J3 = EncPulse2Rad_Read(&Encoder[2], 0);
	J4 = EncPulse2Rad_Read(&Encoder[3], 0);

	BaseENC[0] = TIM2->CNT;
	int ds = BaseENC[0] - BaseENC[1]; //find delta s
	BaseENC[1] = BaseENC[0];
	//Unwrapping position
	if (ds >= 1000) {
		ds -= 1999;
	} else if (ds <= -1000) {
		ds += 1999;
	}
	Chess_Board_Base_Encoder += (ds/2000.0f)*2.0f*PI;

	/***** Joint Space SetPoint Gen *****/
	if (Chessmove_State == 0) {
		if (Traj_Flag & 0x0F) {
			double traj_t_set[5];
			traj_t_set[0] = t;
			traj_t_set[1] = t * t;
			traj_t_set[2] = traj_t_set[1] * t;
			traj_t_set[3] = traj_t_set[2] * t;
			traj_t_set[4] = traj_t_set[3] * t;
			for (int i = 0; i < 4; i++) {
				if (Traj_Flag & (0x01 << i)) {
					TrajFollow(&Traj[i], traj_t_set, &SetPoint_Position[i],
							&SetPoint_Velocity[i]);
					if (t >= Traj[i].T) {
						Traj_Flag &= ((0x01 << i) ^ 0xFF);
					}
				}
			}
			t += delta_t;
		}
	}

	else if (Chessmove_State == 1) {
		if (Traj_Flag & 0x0F) {
			double gamma[3] = { 1, 1, -1 };
			double Chi_t[3];
			double ChiDot_t[3];

			//*********** Chi Output ************//
			double SetPointPosition[4];
			double SetPointVelocity[4];

			double traj_t_set[5];
			traj_t_set[0] = t;
			traj_t_set[1] = t * t;
			traj_t_set[2] = traj_t_set[1] * t;
			traj_t_set[3] = traj_t_set[2] * t;
			traj_t_set[4] = traj_t_set[3] * t;
			for (int i = 4; i < 7; i++) {
				TrajFollow(&Traj[i], traj_t_set, &Chi_t[i], &ChiDot_t[i]);
				if (t >= Traj[i].T) {
					Traj_Flag &= ((0x01 << i) ^ 0xFF);
				}
			}
			IPK(gamma, Chi_t, SetPointPosition);
			IVK(SetPointPosition, ChiDot_t, SetPointVelocity);
			for (int i = 0; i < 4; i++) {
				TrajFollow(&Traj[i], traj_t_set, &SetPointPosition[i],
						&SetPointVelocity[i]);
			}
			t += delta_t;
		}
	}

	CascadeControl(&Control[0], &Kalman[0], J1, SetPoint_Position[0], SetPoint_Velocity[0]);
	CascadeControl(&Control[1], &Kalman[1], J2, SetPoint_Position[1], SetPoint_Velocity[1]);
	CascadeControl(&Control[2], &Kalman[2], J3, SetPoint_Position[2], SetPoint_Velocity[2]);
	CascadeControl(&Control[3], &Kalman[3], J4, SetPoint_Position[3], SetPoint_Velocity[3]);

	Step_Driver(&Stepper[0], Control[0].Output);
	Step_Driver(&Stepper[1], Control[1].Output);
	Step_Driver(&Stepper[2], Control[2].Output);
	Step_Driver(&Stepper[3], Control[3].Output);
}

inline void JMoveTaskSpace(double Task2Go[3], double Time2Move){
	double gamma[3] = { 1, 1, -1 };
	double q_inv[4];
	IPK(gamma, Task2Go, q_inv);
	t = 0;
	for (int i = 0; i < 4; i++) {
		Traj_Coeff_Cal(&Traj[i], Time2Move, q_inv[i], Control[i].PositionFeedback, 0,
				Control[i].VelocityFeedback);
	}
	Traj_Flag = 0x0F;
	Chessmove_State = 0;
}

inline void LMoveTaskSpace(double Task2Go[3], double Time2Move){
	double q_Feed[4];
	double qv_Feed[4];
	double Pne[3];
	double vPne[3];
	q_Feed[0] = Control[0].PositionFeedback;
	q_Feed[1] = Control[1].PositionFeedback;
	q_Feed[2] = Control[2].PositionFeedback;
	q_Feed[3] = Control[3].PositionFeedback;
	qv_Feed[0] = Control[0].VelocityFeedback;
	qv_Feed[1] = Control[1].VelocityFeedback;
	qv_Feed[2] = Control[2].VelocityFeedback;
	qv_Feed[3] = Control[3].VelocityFeedback;

	FPK(q_Feed, 269.0f, Pne);
	FVK(q_Feed, qv_Feed, 269.0f, vPne);
	t = 0;
	for (int i = 4; i < 7; i++) {
		Traj_Coeff_Cal(&Traj[i], Time2Move, Task2Go[i], Pne[i], 0, vPne[i]);
	}
	Traj_Flag = 0x0F;
	Chessmove_State = 1; // Change to TaskSpace Traj
}

void ChessNotMovePathWay(uint8_t Index2Move, double Z_Offset, uint8_t IsJMove,
		uint8_t IsRemove) {
	/***** Encoder Read *****/
	double PositionXY[2];
	double SafePose[3] = { 100, -370, 13 };

	/***** Base Encoder Read *****/
//	BaseEnc = BaseENCRead();   //?????????????????????????????????????????????????????????
	ChessPose(Index2Move, Chess_Board_Base_Encoder, PositionXY);
	double q_Feed[4];
	double Pne[3];
	q_Feed[0] = Control[0].PositionFeedback;
	q_Feed[1] = Control[1].PositionFeedback;
	q_Feed[2] = Control[2].PositionFeedback;
	q_Feed[3] = Control[3].PositionFeedback;
	FPK(q_Feed, 269.0f, Pne);
	double Time2MoveDynamic = 1.2;

	double TaskSpace2Go[3];
	if (Index2Move == 64) {
		if (IsRemove == 1) {
			TaskSpace2Go[0] = SafePose[0] + (PositionX_Remove * 40);
			TaskSpace2Go[1] = SafePose[1];
			TaskSpace2Go[2] = Z_TopOffset;
			Time2MoveDynamic += (sqrt(
					((TaskSpace2Go[0] - Pne[0]) * (TaskSpace2Go[0] - Pne[0]))
							+ ((TaskSpace2Go[1] - Pne[1])
									* (TaskSpace2Go[1] - Pne[1])
									+ ((TaskSpace2Go[2] - Pne[2])
											* (TaskSpace2Go[2] - Pne[2])))))
					* 0.0067;
			if (IsJMove) {
				JMoveTaskSpace(TaskSpace2Go, Time2MoveDynamic);
			} else {
				JMoveTaskSpace(TaskSpace2Go, 2);
			}
		} else if (IsRemove == 2) {
			TaskSpace2Go[0] = SafePose[0] + (PositionX_Remove * 40);
			TaskSpace2Go[1] = SafePose[1];
			TaskSpace2Go[2] = SafePose[2];
			PositionX_Remove += 1;

			Time2MoveDynamic += (sqrt(
					((TaskSpace2Go[0] - Pne[0]) * (TaskSpace2Go[0] - Pne[0]))
							+ ((TaskSpace2Go[1] - Pne[1])
									* (TaskSpace2Go[1] - Pne[1])
									+ ((TaskSpace2Go[2] - Pne[2])
											* (TaskSpace2Go[2] - Pne[2])))))
					* 0.0067;
			if (IsJMove) {
				JMoveTaskSpace(TaskSpace2Go, Time2MoveDynamic);
			} else {
				JMoveTaskSpace(TaskSpace2Go, 2);
			}
		}
	} else {
		float Z_Board_Offset;
		if (PositionXY[0] > 250 && PositionXY[0] < 450) {
			Z_Board_Offset = (PositionXY[0] - 250) * 0.05f;
		} else if (PositionXY[0] > 450 && PositionXY[0] < 700) {
			Z_Board_Offset = (PositionXY[0] - 450) * 0.11f;
		}
		TaskSpace2Go[0] = PositionXY[0];
		TaskSpace2Go[1] = PositionXY[1];
		TaskSpace2Go[2] = Z_Offset + ChessHight + Z_Board_Offset;

		Time2MoveDynamic += (sqrt(
				((TaskSpace2Go[0] - Pne[0]) * (TaskSpace2Go[0] - Pne[0]))
						+ ((TaskSpace2Go[1] - Pne[1])
								* (TaskSpace2Go[1] - Pne[1])
								+ ((TaskSpace2Go[2] - Pne[2])
										* (TaskSpace2Go[2] - Pne[2])))))
				* 0.0067;

		if (IsJMove) {
			JMoveTaskSpace(TaskSpace2Go, Time2MoveDynamic);
		} else {
			JMoveTaskSpace(TaskSpace2Go, 2);
		}
	}
}

void ChessMoveStateMachine() {
	static uint8_t ChangeState = 0;
	double Speed_Error = 0.05;
	double SafePose[3] = {210, -270, 250};
	double Time2MoveDynamic = 1.3;
	double q_Feed[4];
	double Pne[3];

	switch (ChessMoveStates) {
	case Chess_idle:
		HAL_GPIO_WritePin(LED4_GPIO_Port, LED4_Pin, 0);
		if (Chess_Move_Start_Flag) {
			ChessMoveStates = Move_2_Start_Top_Point;
			HAL_GPIO_WritePin(LED4_GPIO_Port, LED4_Pin, 1);
			Servo_Drive(&Servo[1], 90);
			ChangeState = 1;
			}
		break;
	case Move_2_Start_Top_Point:
		if (ChangeState) {
			ChessNotMovePathWay(ChessIndex[0], Z_TopOffset, 1 , 0);
			ChangeState = 0;
		}
		if (!Traj_Flag) {
			if(All_Joint_Speed_Avg() <= Speed_Error){
				ChessMoveStates = Move_2_Start_Grip_Point;
				Servo_Drive(&Servo[1], 90.0f + Control[0].PositionFeedback - Chess_Board_Base_Encoder);
				ChangeState = 1;
			}
		}
		break;
	case Move_2_Start_Grip_Point:
		if (ChangeState) {
			ChessNotMovePathWay(ChessIndex[0], Z_2GripOffset, 0, 1);
			ChangeState = 0;
		}
		if (!Traj_Flag) {
			if (All_Joint_Speed_Avg() <= Speed_Error) {
				ChessMoveStates = Move_2_Start_Point_and_Griping;
				Servo_Drive(&Servo[0], 110); //Ungrip
				ChangeState = 1;
			}
		}
		break;
	case Move_2_Start_Point_and_Griping:
		// Grip Chess
		Servo_Drive(&Servo[0], 25); //Grip
		ChessMoveStates = Back_2_Start_Top_Point;
		break;
	case Back_2_Start_Top_Point:
		if (ChangeState) {
			ChessNotMovePathWay(ChessIndex[0], Z_TopOffset, 0, 1);
			ChangeState = 0;
		}
		if (!Traj_Flag) {
			if (All_Joint_Speed_Avg() <= Speed_Error) {
				ChessMoveStates = Move_2_End_Top_Point;
				ChangeState = 1;
			}
		}
		break;

		// Finish To Grip Chess

	case Move_2_End_Top_Point:
		if (ChangeState) {
			ChessNotMovePathWay(ChessIndex[1], Z_TopOffset, 1, 1);
			ChangeState = 0;
		}
		if (!Traj_Flag) {
			if (All_Joint_Speed_Avg() <= Speed_Error) {
				Servo_Drive(&Servo[1],
						90.0f - Control[0].PositionFeedback	+ Chess_Board_Base_Encoder);
				ChessMoveStates = Move_2_End_Ungrip_Point;
				ChangeState = 1;
			}
		}
		break;
	case Move_2_End_Ungrip_Point:
		if (ChangeState) {
			ChessNotMovePathWay(ChessIndex[1], Z_2GripOffset, 0, 1);
			ChangeState = 0;
		}
		if (!Traj_Flag) {
			if (All_Joint_Speed_Avg() <= Speed_Error) {
				if (ChessIndex[1] == 64) {
					ChessMoveStates = Move_2_End_Remove_Point_and_Ungriping;
					ChangeState = 1;
				} else {
					ChessMoveStates = Move_2_End_Point_and_Ungriping;
					ChangeState = 1;
				}
			}
		}
		break;
	case Move_2_End_Remove_Point_and_Ungriping:
		if (ChangeState) {
			ChessNotMovePathWay(ChessIndex[1], Z_2GripOffset, 0, 2);
			ChangeState = 0;
		}
		if (!Traj_Flag) {
			if (All_Joint_Speed_Avg() <= Speed_Error) {
				ChessMoveStates = Move_2_End_Point_and_Ungriping;
				ChangeState = 1;
			}
		}
		break;
	case Move_2_End_Point_and_Ungriping:
		Servo_Drive(&Servo[0], 110); //Ungrip
		ChessMoveStates = Back_2_End_Top_Point;
		ChangeState = 1;
		break;
	case Back_2_End_Top_Point:
		if (ChangeState) {
			ChessNotMovePathWay(ChessIndex[1], Z_TopOffset, 0, 1);
			ChangeState = 0;
		}
		if (!Traj_Flag) {
			if (All_Joint_Speed_Avg() <= Speed_Error) {
				ChessMoveStates = ChessMove_Finish;
				ChangeState = 1;
			}
		}
		break;
	case ChessMove_Finish:
		if (ChangeState) {
			q_Feed[0] = Control[0].PositionFeedback;
			q_Feed[1] = Control[1].PositionFeedback;
			q_Feed[2] = Control[2].PositionFeedback;
			q_Feed[3] = Control[3].PositionFeedback;
			FPK(q_Feed, 269.0f, Pne);
			Time2MoveDynamic +=
					(sqrt(
							((SafePose[0] - Pne[0]) * (SafePose[0] - Pne[0]))
									+ ((SafePose[1] - Pne[1])
											* (SafePose[1] - Pne[1]))
									+ ((SafePose[2] - Pne[2])
											* (SafePose[2] - Pne[2]))))
							* 0.0075;
			JMoveTaskSpace(SafePose, Time2MoveDynamic);
			ChangeState = 0;
		}
		if (!Traj_Flag) {
			if (All_Joint_Speed_Avg() <= Speed_Error) {
				ChessMoveStates = Chess_idle;
				Chess_Move_Start_Flag = 0;
				ChangeState = 1;
			}
		}
		break;
	default:
		break;
	}
}

double All_Joint_Speed_Avg(){
	double Buf;
	for (int i=4;i<4;i++){
		Buf += fabs(Control[i].VelocityFeedback);
	}
	return Buf/4.0f;
}

/* USER CODE END 4 */
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
