TsBeNz/Narwhal-Robot-Embedded-Systems/LowLevel_Code/Master_Config_STM32H733/Master_Config_STM32H733.ioc

Mcu.UserName=STM32H733VGTx
PA0.Signal=S_TIM5_CH1
PA1.Signal=S_TIM5_CH2
PA10.GPIO_Label=ENC6I
PA10.Signal=GPIO_Input
PA11.Signal=USB_OTG_HS_DM
PA12.Signal=USB_OTG_HS_DP
PA13(JTMS/SWDIO).Signal=DEBUG_JTMS-SWDIO
PA14(JTCK/SWCLK).Signal=DEBUG_JTCK-SWCLK
PA15(JTDI).GPIO_Label=ENC6A
PA15(JTDI).Signal=S_TIM2_CH1_ETR
PA6.GPIO_Label=STEP1
PA6.Signal=S_TIM13_CH1
PA7.GPIO_Label=STEP2
PA7.Signal=S_TIM14_CH1
PA8.GPIO_Label=ENC4A_Neopixel
PA8.Signal=S_TIM1_CH1
PA9.GPIO_Label=ENC4B
PA9.Signal=S_TIM1_CH2
PB1.GPIO_Label=EMSW0
PB1.Signal=GPXTI1
PB10.Signal=I2C2_SCL
PB11.Signal=I2C2_SDA
PB12.Signal=UART5_RX
PB13.Signal=UART5_TX
PB14.Signal=USART1_TX
PB15.Signal=USART1_RX
PB2.GPIO_Label=EMSW1
PB2.Signal=GPIO_Output
PB3(JTDO/TRACESWO).GPIO_Label=ENC6B
PB3(JTDO/TRACESWO).Signal=S_TIM2_CH2
PB4(NJTRST).GPIO_Label=ENC5A_GriperA
PB4(NJTRST).Signal=S_TIM3_CH1
PB5.GPIO_Label=ENC5B_GriperB
PB5.Signal=S_TIM3_CH2
PB6.GPIO_Label=EN45
PB6.Signal=GPIO_Output
PB7.GPIO_Label=EN123
PB7.Signal=GPIO_Output
PB8.GPIO_Label=STEP4
PB8.Signal=S_TIM16_CH1
PB9.GPIO_Label=STEP5
PB9.Signal=S_TIM17_CH1
PC10.Signal=SPI3_SCK
PC11.Signal=SPI3_MISO
PC12.Signal=SPI3_MOSI
PC4.GPIO_Label=Griper0
PC4.Signal=GPIO_Output
PC5.Signal=ADCx_INP8
PC6.GPIO_Label=ENC3A
PC6.Signal=S_TIM8_CH1
PC7.GPIO_Label=ENC3B
PC7.Signal=S_TIM8_CH2
PC8.GPIO_Label=LED2
PC8.Signal=GPIO_Output
PC9.GPIO_Label=LED1
PC9.Signal=GPIO_Output
PD0.GPIO_Label=SPI3_SS6
PD0.Signal=GPIO_Output
PD1.GPIO_Label=SPI3_SS5
PD1.Signal=GPIO_Output
PD12.GPIO_Label=ENC2A
PD12.Signal=S_TIM4_CH1
PD13.GPIO_Label=ENC2B
PD13.Signal=S_TIM4_CH2
PD14.GPIO_Label=LED4
PD14.Signal=GPIO_Output
PD15.GPIO_Label=LED3
PD15.Signal=GPIO_Output
PD2.GPIO_Label=SPI3_SS4
PD2.Signal=GPIO_Output
PD3.GPIO_Label=SPI3_SS3
PD3.Signal=GPIO_Output
PD4.GPIO_Label=SPI3_SS2
PD4.Signal=GPIO_Output
PD5.GPIO_Label=SPI3_SS1
PD5.Signal=GPIO_Output
PD6.GPIO_Label=SPI3_EN
PD6.Signal=GPIO_Output
PD8.Signal=USART3_TX
PD9.Signal=USART3_RX
PE0.GPIO_Label=DIR1
PE0.Signal=GPIO_Output
PE1.GPIO_Label=DIR2
PE1.Signal=GPIO_Output
PE11.GPIO_Label=EERAM_SS
PE11.Signal=GPIO_Output
PE12.GPIO_Label=SPI4_SCK
PE12.Signal=SPI4_SCK
PE13.Signal=SPI4_MISO
PE14.Signal=SPI4_MOSI
PE15.GPIO_Label=EERAM_HOLD
PE15.Signal=GPIO_Output
PE2.GPIO_Label=DIR3
PE2.Signal=GPIO_Output
PE3.GPIO_Label=DIR4
PE3.Signal=GPIO_Output
PE4.GPIO_Label=DIR5
PE4.Signal=GPIO_Output
PE5.Signal=S_TIM15_CH1
PE6.GPIO_Label=Output_EN
PE6.Signal=GPIO_Output
PE7.GPIO_Label=EMSW2
PE7.Signal=GPIO_Output
PE8.GPIO_Label=EMSW3
PE8.Signal=GPIO_Output
PE9.GPIO_Label=EMSW4
PE9.Signal=GPIO_Output
PH0-OSC_IN.Signal=RCC_OSC_IN
PH1-OSC_OUT.Signal=RCC_OSC_OUT
