TsBeNz/Narwhal-Robot-Embedded-Systems/LowLevel_Code/Narwhale_Kinematics/Core/Src/main.c

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
/* Includes ------------------------------------------------------------------*/
#include "main.h"
#include "usb_device.h"
#include "kinematics.h"
/* USER CODE BEGIN PD */
//	float v_x[2] = {400.01,500};
//	float v_y[2]= {0,0};
//	float v_z[2] = {420.99,260};
//	float v_pitch[2] = {-3.1416,-3.1416};
//	float v_yaw[2] = {3.1416,3.1416};
	float q[5]={0,-0.6975,0.5554,0.1421,0};
	float qv[5];
	float v_x, v_y, v_z, v_pitch, v_yaw;

/* USER CODE END PD */

ADC_HandleTypeDef hadc3;

CRC_HandleTypeDef hcrc;

I2C_HandleTypeDef hi2c2;

SPI_HandleTypeDef hspi3;
SPI_HandleTypeDef hspi4;

TIM_HandleTypeDef htim1;
TIM_HandleTypeDef htim2;
TIM_HandleTypeDef htim3;
TIM_HandleTypeDef htim4;
TIM_HandleTypeDef htim5;
TIM_HandleTypeDef htim6;
TIM_HandleTypeDef htim8;
TIM_HandleTypeDef htim13;
TIM_HandleTypeDef htim14;
TIM_HandleTypeDef htim15;
TIM_HandleTypeDef htim16;
TIM_HandleTypeDef htim17;
TIM_HandleTypeDef htim23;
TIM_HandleTypeDef htim24;

UART_HandleTypeDef huart1;
UART_HandleTypeDef huart3;
DMA_HandleTypeDef hdma_usart1_rx;

void SystemClock_Config(void);
void PeriphCommonClock_Config(void);
static void MX_GPIO_Init(void);
static void MX_DMA_Init(void);
static void MX_ADC3_Init(void);
static void MX_TIM1_Init(void);
static void MX_TIM3_Init(void);
static void MX_TIM4_Init(void);
static void MX_TIM5_Init(void);
static void MX_TIM8_Init(void);
static void MX_TIM13_Init(void);
static void MX_TIM14_Init(void);
static void MX_TIM15_Init(void);
static void MX_TIM16_Init(void);
static void MX_TIM17_Init(void);
static void MX_USART1_UART_Init(void);
static void MX_USART3_UART_Init(void);
static void MX_SPI3_Init(void);
static void MX_SPI4_Init(void);
static void MX_TIM2_Init(void);
static void MX_I2C2_Init(void);
static void MX_CRC_Init(void);
static void MX_TIM24_Init(void);
static void MX_TIM23_Init(void);
static void MX_TIM6_Init(void);
/**
  * @brief  The application entry point.
  * @retval int
  */
int main(void)
{
  /* USER CODE BEGIN 1 */
	uint32_t timer1;
	v_x = 0.000023997;
	v_y = 0;
	v_z = -0.000038637;
	v_pitch = 0;
	v_yaw = 0;

  /* USER CODE END 1 */

  /* MCU Configuration--------------------------------------------------------*/

  /* Reset of all peripherals, Initializes the Flash interface and the Systick. */
  HAL_Init();

  /* Configure the system clock */
  SystemClock_Config();

/* Configure the peripherals common clocks */
  PeriphCommonClock_Config();

  /* Initialize all configured peripherals */
  MX_GPIO_Init();
  MX_DMA_Init();
  MX_ADC3_Init();
  MX_TIM1_Init();
  MX_TIM3_Init();
  MX_TIM4_Init();
  MX_TIM5_Init();
  MX_TIM8_Init();
  MX_TIM13_Init();
  MX_TIM14_Init();
  MX_TIM15_Init();
  MX_TIM16_Init();
  MX_TIM17_Init();
  MX_USART1_UART_Init();
  MX_USART3_UART_Init();
  MX_SPI3_Init();
  MX_SPI4_Init();
  MX_TIM2_Init();
  MX_I2C2_Init();
  MX_CRC_Init();
  MX_USB_DEVICE_Init();
  MX_TIM24_Init();
  MX_TIM23_Init();
  MX_TIM6_Init();
  /* Infinite loop */
  /* USER CODE BEGIN WHILE */
	while (1) {
    /* USER CODE END WHILE */

    /* USER CODE BEGIN 3 */
//		if (HAL_GetTick() - timer1 > 1000) { gettick จะนับไปเรื่อย
//			timer1 = HAL_GetTick(); keep count ตอนนั้นไว้ที่ timer1
//			HAL_GPIO_TogglePin(GPIOC, GPIO_PIN_9);
//		}
//		float a = cos(3.14);
		IVK(v_x, v_y, v_z, v_pitch, v_yaw, q, qv);

  }
  /* USER CODE END 3 */
}

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
