TsBeNz/Narwhal-Robot-Embedded-Systems/(commit log)

2022-01-18 remember these files
    [J5.STEP, assJ5.SLDASM, link4.STL]
2022-01-22 MCU Board Narwhals
    [EERAM.kicad_sch, ENC.kicad_sch, LVDS.kicad_sch, Logic_Conv.kicad_sch, MCU.kicad_sch, NarwhelMainV2.kicad_pcb, NarwhelMainV2.kicad_sch, PSU.kicad_sch]
2022-01-22 Update Project MCU Board
    [NarwhelMainV2.kicad_pcb, NarwhelMainV2.kicad_sch, USB.kicad_sch]
2022-01-23 Final Encoder PCB
    [EERAM.kicad_sch, NarWhelEncoderV2.kicad_pcb, NarWhelEncoderV2.kicad_sch, NarwhelMainV2.kicad_pcb, NarwhelMainV2.kicad_sch]
2022-01-24 no longer define parameters
    [kinematics.c]
2022-01-24 Update Board
    [EERAM.kicad_sch, LVDS.kicad_sch, MCU.kicad_sch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]
2022-01-28 Update Code STM32 (Control ,Kalman & Trajectory Following)
2022-02-05 Update Control
    - Control (Position Velocity)
    - Kalman filter (STM32,Matlab)
    - Encoder (AS5047U)
2022-02-06 Update Matlab Kalman filter
    - Kalman filter Function
    - Kalman filter Code gen
2022-02-09 update Kalman filter
2022-02-09 update Code STM32
2022-02-22 update plot taskspace_traj
    [GripperASM.STL]
2022-02-24 Driver Step1
2022-02-25 Update Joint Trajectory
2022-04-12 update New PID Parameter
2022-04-17 update planning Traj.
    [sampledata_IVKtest.xlsx]
2022-04-27 Final Low LV with Chess Board Encoder
